VoronDesign/Voron-Stealthburner/README.md

# Voron Stealthburner

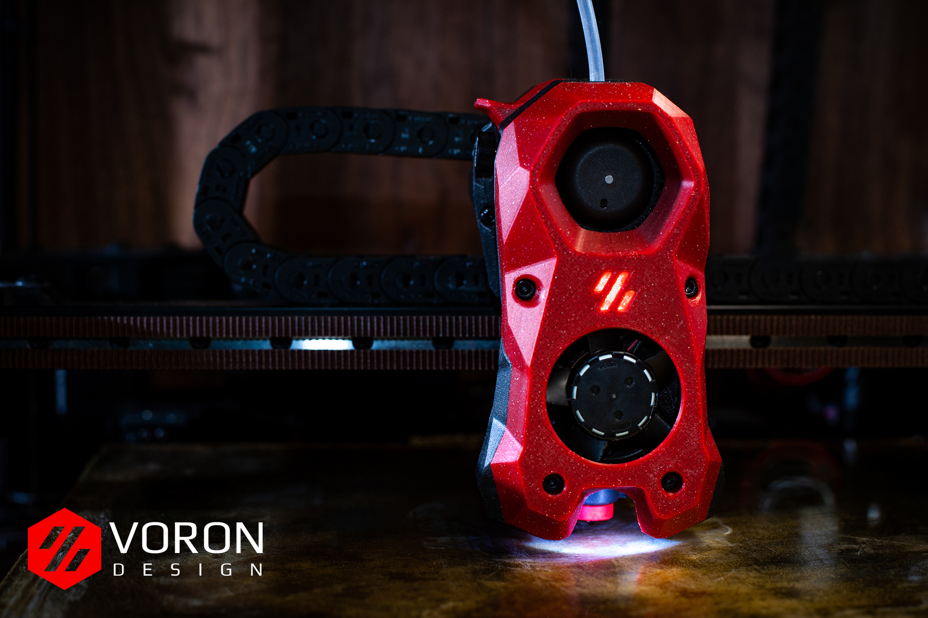
[picture p1: Images/Voron_Stealthburner.JPG]
Voron_Stealthburner
