VoronDesign/Voron-Stealthburner/STLs/README.md

# Filename Nomenclature

| Filename | Note |
|---|---|
| \*.stl | Base color |
| [a]\_\*.stl | Accent color |
| [o]\_\*.stl | Opaque (light doesn't penetrate) |
| [c]\_\*.stl | Clear/Translucent (light can penetrate) |
| \*\_cw1.stl | Clockwork1 Version |
| \*\_cw2.stl | Clockwork2 Version |
| \*\_SW.stl | Switchwire Version |

# NOTE: The X Carriage files are in each printers repo and not in the Stealthburner repo
