VoronDesign/Voron-Stealthburner/STLs/Clockwork2/Direct_Drive/main_body.stl

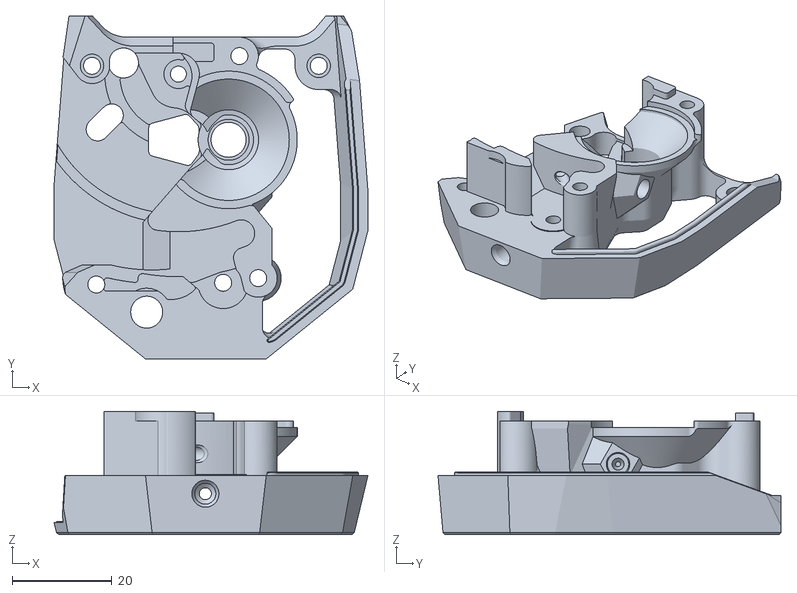
[picture p3: CAD file, 2023-07-12]
STLs/Clockwork2/Direct_Drive/main_body.stl
62.8 x 68.7 x 24.7
