VoronDesign/Voron-Stealthburner/STLs/Stealthburner/[a]_stealthburner_main_body.stl

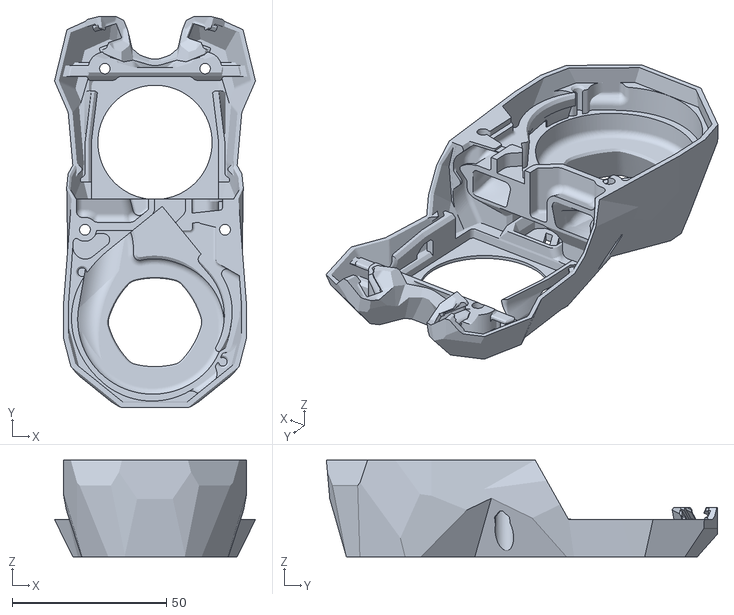
[picture p4: CAD file, 2026-11-07]
STLs/Stealthburner/[a]_stealthburner_main_body.stl
65.1 x 126.8 x 31.4
