VoronDesign/Voron-Stealthburner/STLs/Clockwork2.5/Direct_Drive/main_body_collet.stl

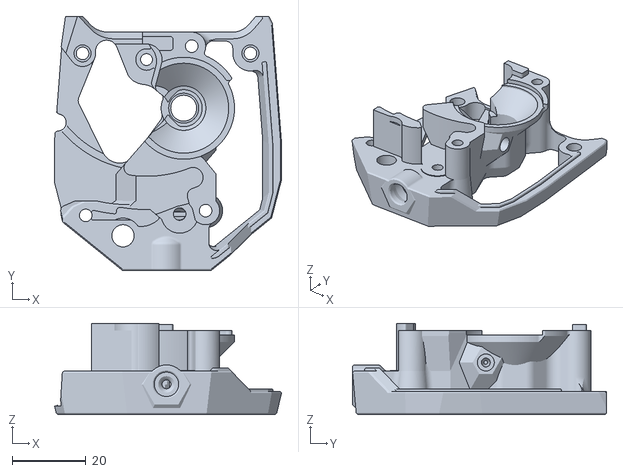
[picture p5: CAD file, 2026-11-07]
STLs/Clockwork2.5/Direct_Drive/main_body_collet.stl
61.4 x 68.7 x 24.7
