VoronDesign/Voron-Stealthburner/CAD/Printheads/Stealthburner_Printhead_Dragon.step

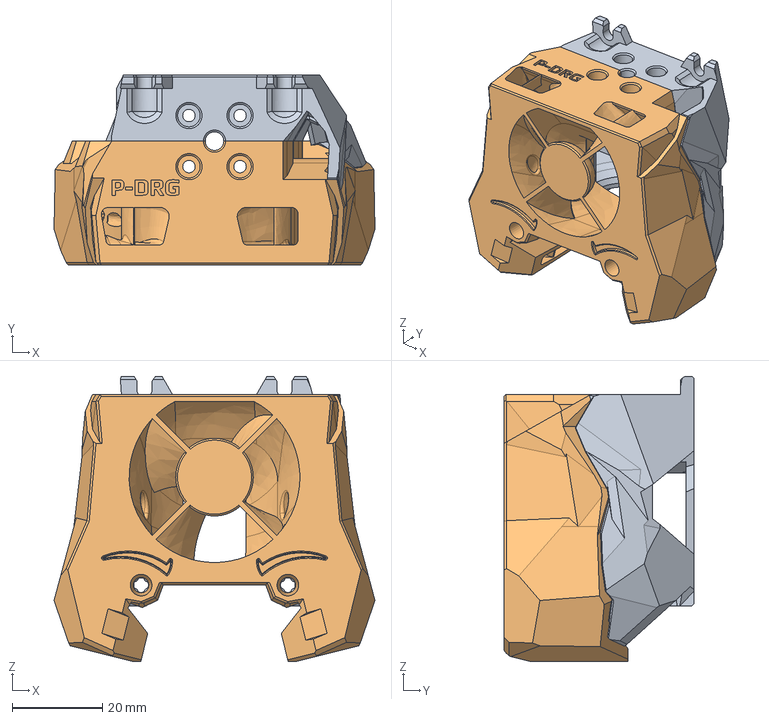
[picture p7: CAD file, 2026-11-07]
CAD/Printheads/Stealthburner_Printhead_Dragon.step
71.1 x 42.0 x 63.1 mm
