VoronDesign/Voron-Stealthburner/STLs/Clockwork2.5/chain_anchor_2hole_SW.stl

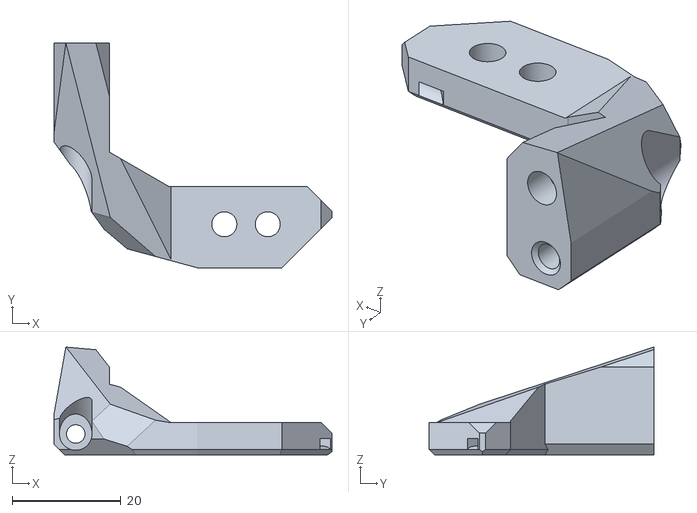
[picture p8: CAD file, 2026-11-07]
STLs/Clockwork2.5/chain_anchor_2hole_SW.stl
51.2 x 41.3 x 19.9
