VoronDesign/Voron-Stealthburner/STLs/Clockwork2.5/Direct_Drive/motor_plate.stl

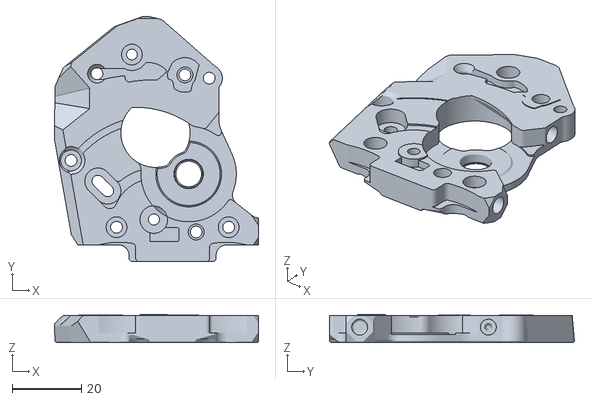
[picture p9: CAD file, 2026-11-08]
STLs/Clockwork2.5/Direct_Drive/motor_plate.stl
59.1 x 70.8 x 8.20
