VoronDesign/Voron-Stealthburner/STLs/Clockwork2/Bowden/front_stealthburner_bowden_ECAS_x1.stl

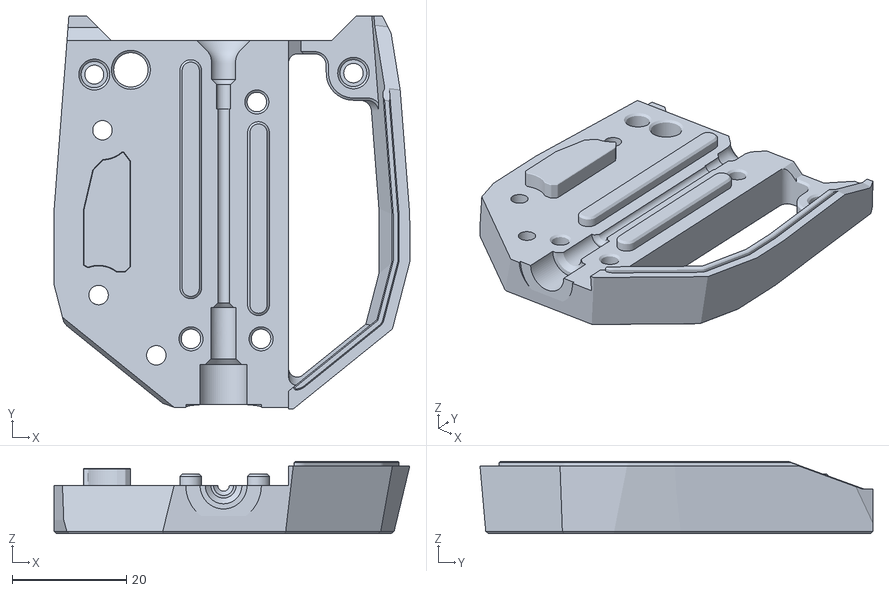
[picture p10: CAD file, 2023-07-11]
STLs/Clockwork2/Bowden/front_stealthburner_bowden_ECAS_x1.stl
62.2 x 68.7 x 12.6
