VoronDesign/Voron-Stealthburner/STLs/Clockwork2/chain_anchor_3hole_SW.stl

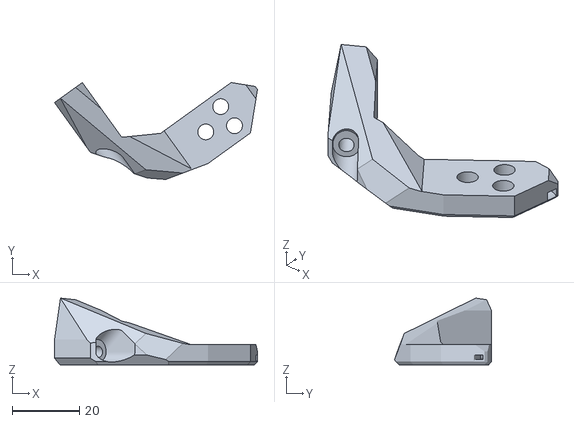
[picture p11: CAD file, 2023-09-07]
STLs/Clockwork2/chain_anchor_3hole_SW.stl
60.3 x 28.8 x 19.9
