VoronDesign/Voron-Stealthburner/STLs/Stealthburner/ADXL345_Mounts/sb_adxl_mount_ldo_15mm_c_c.stl

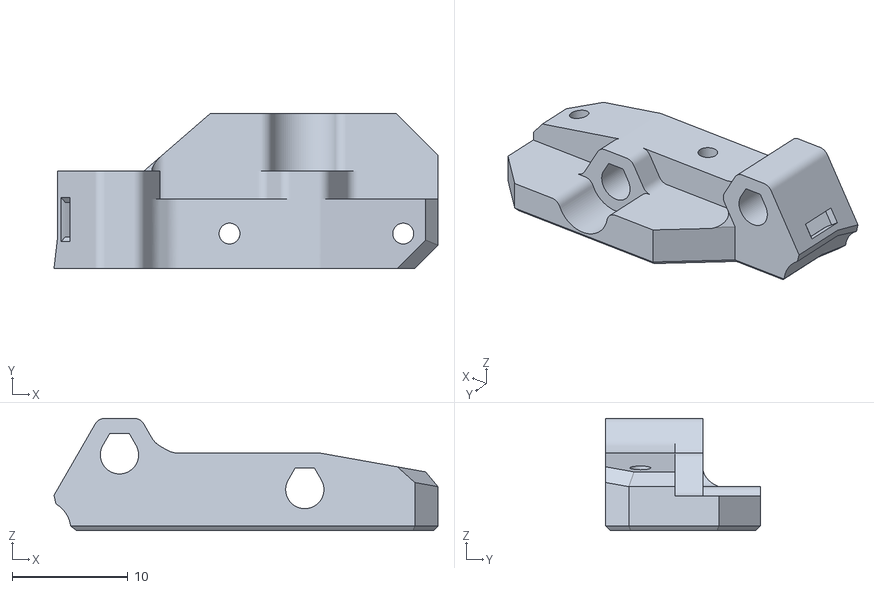
[picture p12: CAD file, 2022-07-23]
STLs/Stealthburner/ADXL345_Mounts/sb_adxl_mount_ldo_15mm_c_c.stl
33.2 x 13.4 x 9.70
