VoronDesign/Voron-Stealthburner/STLs/Stealthburner/Printheads/chube_compact/stealthburner_printhead_chube_compact_rear_cw2.stl

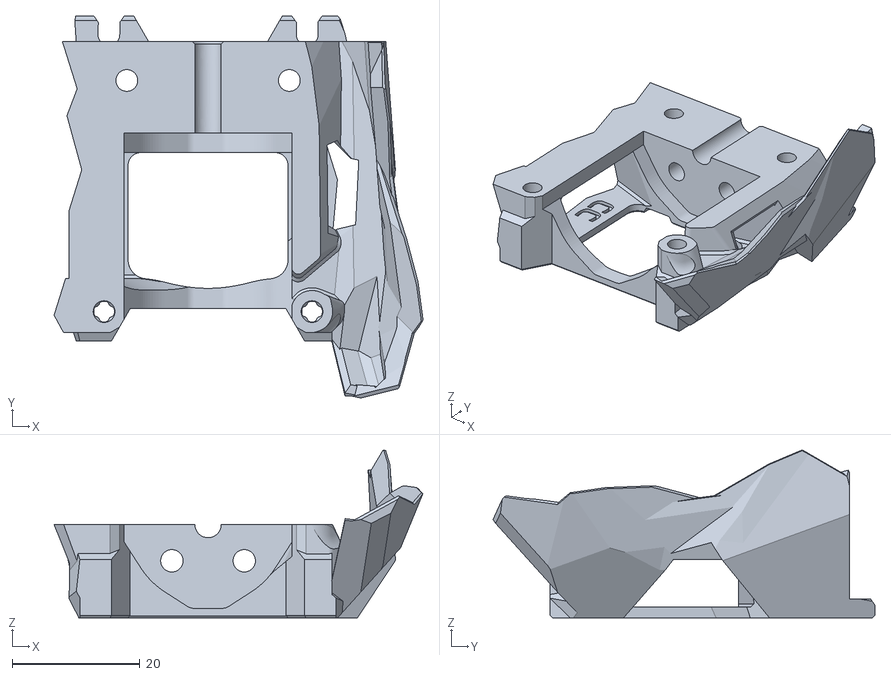
[picture p13: CAD file, 2026-11-07]
STLs/Stealthburner/Printheads/chube_compact/stealthburner_printhead_chube_compact_rear_cw2.stl
57.7 x 59.7 x 26.3
