VoronDesign/Voron-Stealthburner/STLs/Stealthburner/Printheads/phaetus_bmo/stealthburner_printhead_phaetus_bmo_rear_cw2.stl

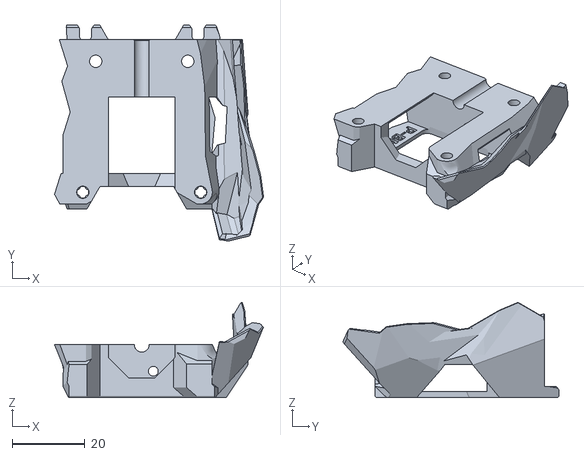
[picture p14: CAD file, 2026-11-07]
STLs/Stealthburner/Printheads/phaetus_bmo/stealthburner_printhead_phaetus_bmo_rear_cw2.stl
57.7 x 59.7 x 26.3
