VoronDesign/Voron-Stealthburner/STLs/Stealthburner/Printheads/phaetus_rapido_v2/stealthburner_printhead_rapido_v2_front.stl

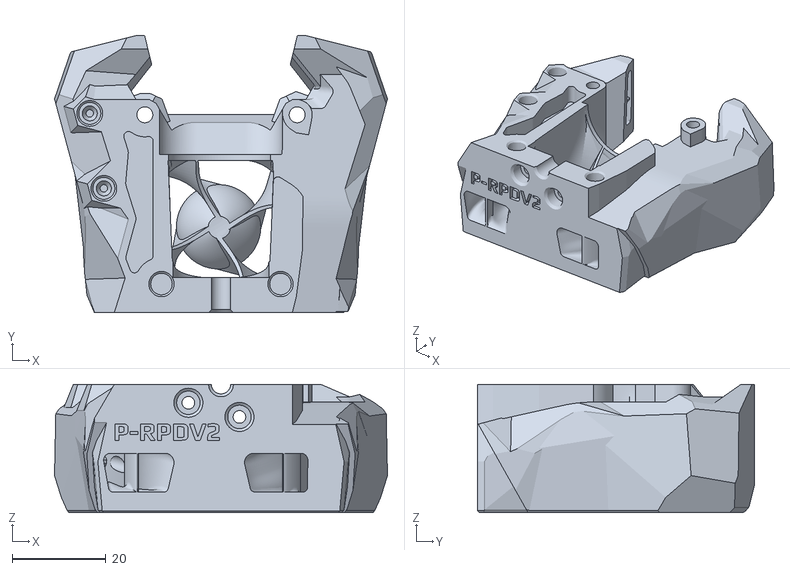
[picture p15: CAD file, 2026-11-07]
STLs/Stealthburner/Printheads/phaetus_rapido_v2/stealthburner_printhead_rapido_v2_front.stl
71.1 x 59.1 x 27.4
