VoronDesign/Voron-Stealthburner/STLs/Stealthburner/Printheads/revo_six_and_v6/stealthburner_printhead_v6_r6_rear_cw2.stl

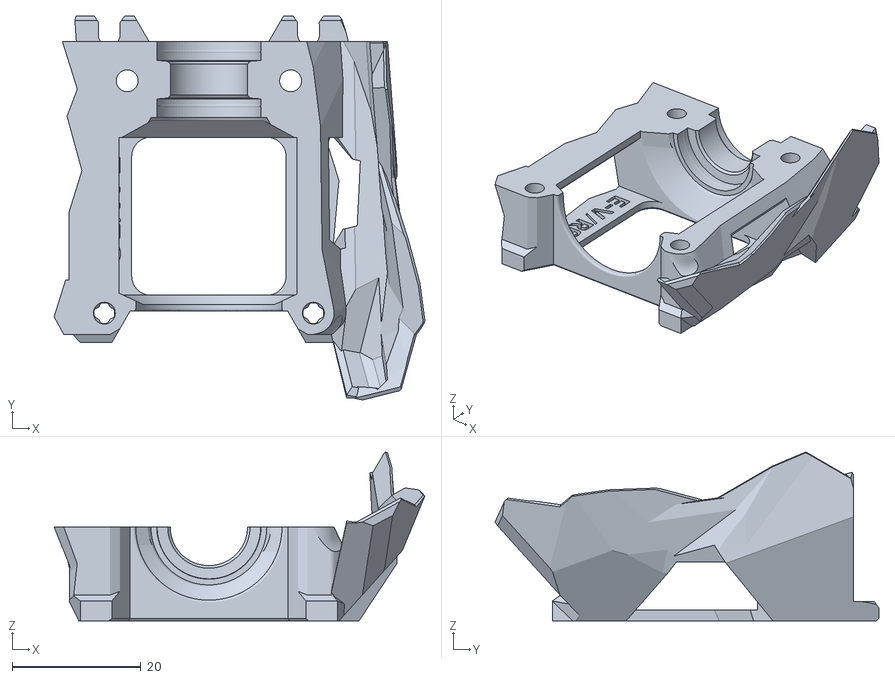
[picture p16: CAD file, 2022-09-28]
STLs/Stealthburner/Printheads/revo_six_and_v6/stealthburner_printhead_v6_r6_rear_cw2.stl
57.7 x 59.7 x 26.3
