VoronDesign/Voron-Stealthburner/STLs/Tools/SB_5015_Cutting_Tool_B.stl

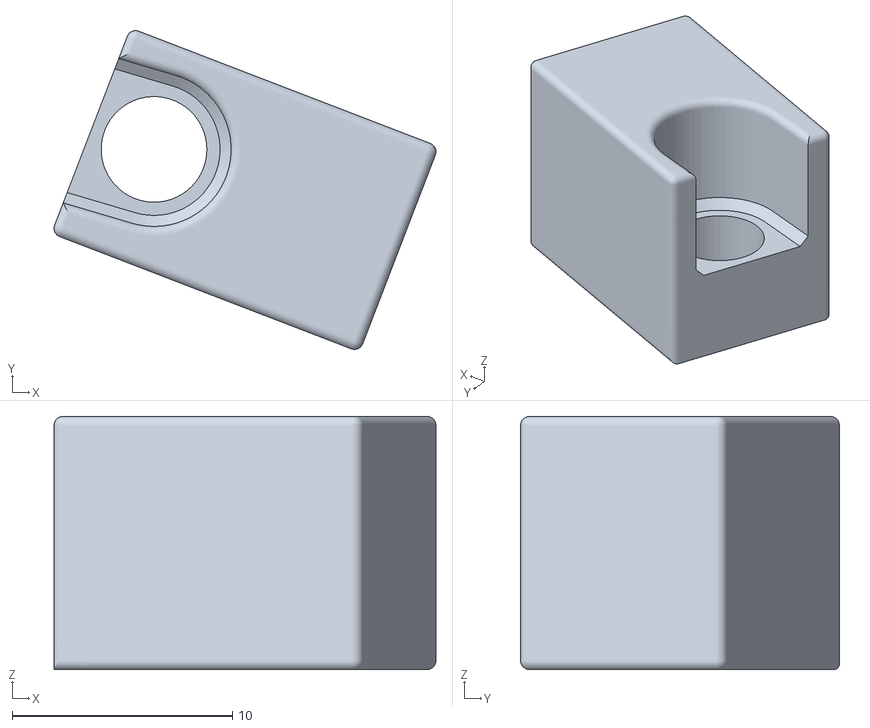
[picture p17: CAD file, 2022-07-25]
STLs/Tools/SB_5015_Cutting_Tool_B.stl
17.4 x 14.5 x 11.5
