VoronDesign/Voron-Stealthburner/CAD/Printheads/Stealthburner_Printhead_Rapido.step

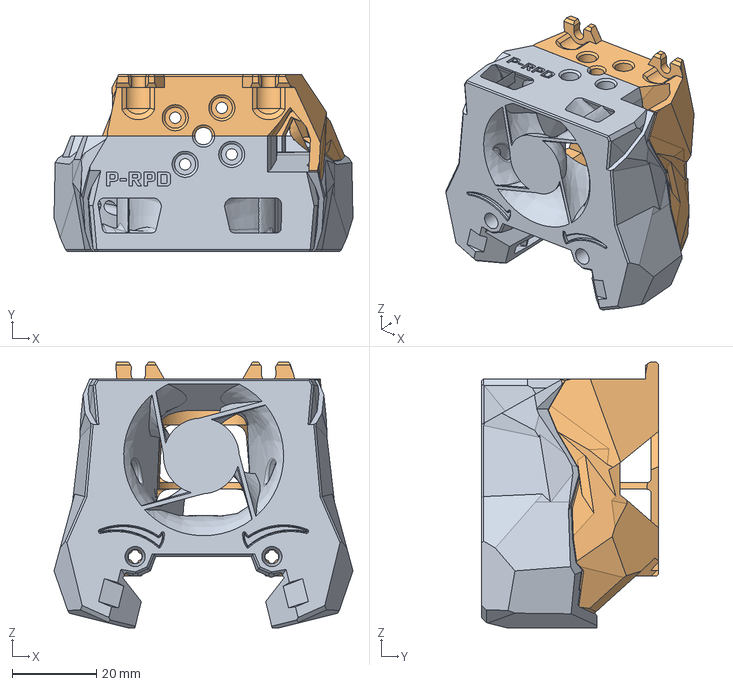
[picture p18: CAD file, 2026-11-07]
CAD/Printheads/Stealthburner_Printhead_Rapido.step
71.1 x 42.0 x 63.1 mm
SBRapido TH Front
SBRapido TH Rear CW2
