VoronDesign/Voron-Stealthburner/STLs/Clockwork2.5/Direct_Drive/[a]_guidler_b.stl

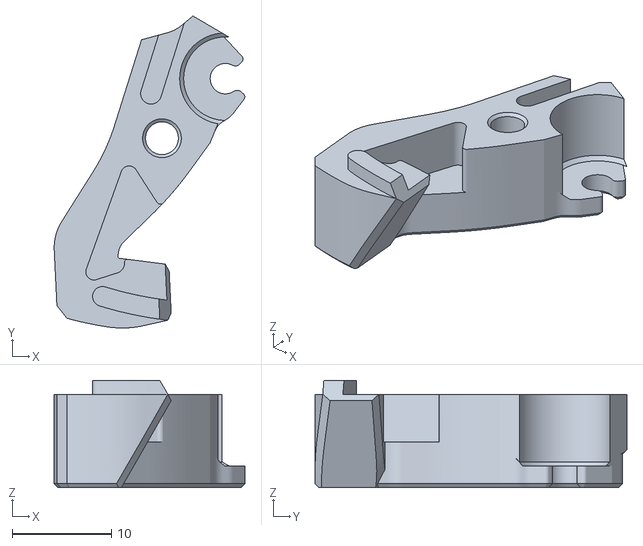
[picture p20: CAD file, 2026-11-07]
STLs/Clockwork2.5/Direct_Drive/[a]_guidler_b.stl
19.2 x 31.4 x 10.8
