VoronDesign/Voron-Stealthburner/STLs/Clockwork2/chain_anchor_2hole_SW.stl

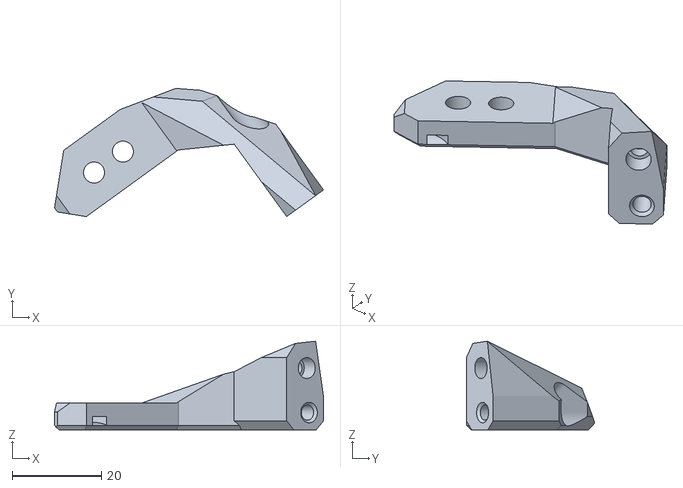
[picture p21: CAD file, 2023-09-07]
STLs/Clockwork2/chain_anchor_2hole_SW.stl
60.3 x 28.7 x 19.9
