VoronDesign/Voron-Stealthburner/STLs/Clockwork2/Direct_Drive/[a]_latch.stl

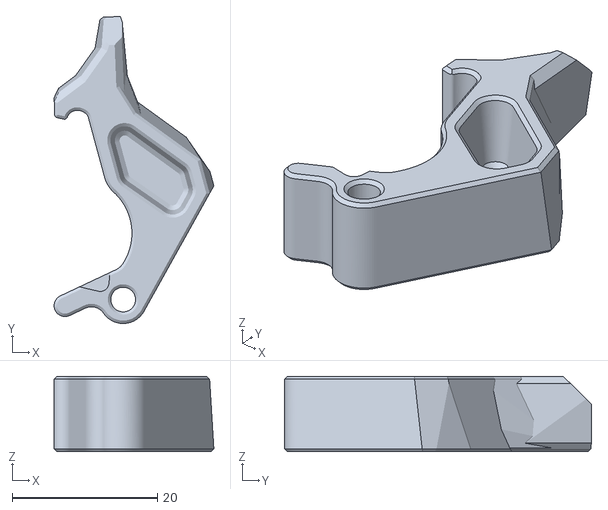
[picture p22: CAD file, 2023-07-11]
STLs/Clockwork2/Direct_Drive/[a]_latch.stl
22.0 x 42.3 x 10.4
