VoronDesign/Voron-Stealthburner/STLs/Stealthburner/[o]_stealthburner_LED_carrier.stl

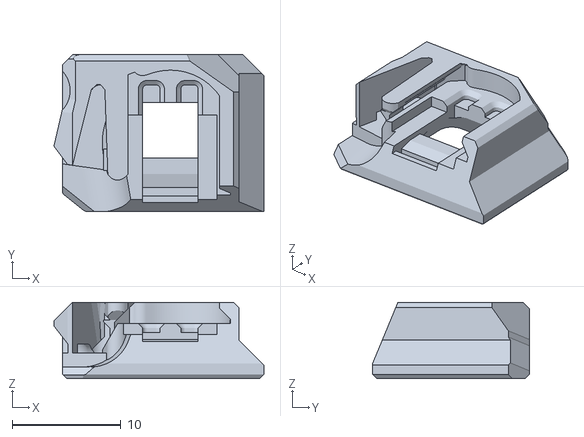
[picture p23: CAD file, 2022-07-23]
STLs/Stealthburner/[o]_stealthburner_LED_carrier.stl
19.3 x 14.4 x 7.01
