VoronDesign/Voron-Stealthburner/STLs/Stealthburner/ADXL345_Mounts/sb_adxl_mount_sparkfun_LIS3DH.stl

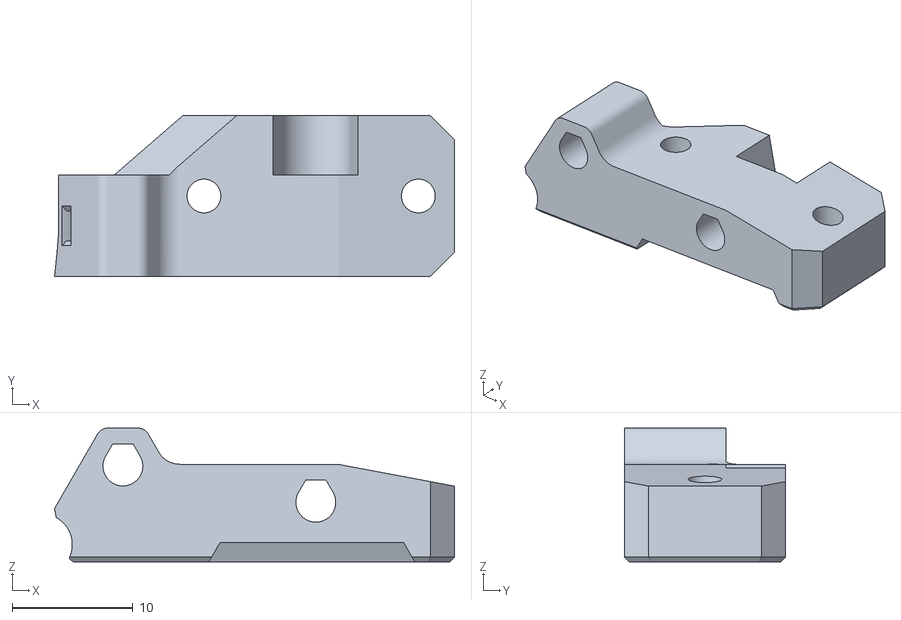
[picture p24: CAD file, 2022-07-23]
STLs/Stealthburner/ADXL345_Mounts/sb_adxl_mount_sparkfun_LIS3DH.stl
33.2 x 13.4 x 11.1
