VoronDesign/Voron-Stealthburner/STLs/Stealthburner/Printheads/phaetus_bms/stealthburner_printhead_phaetus_bms7_front.stl

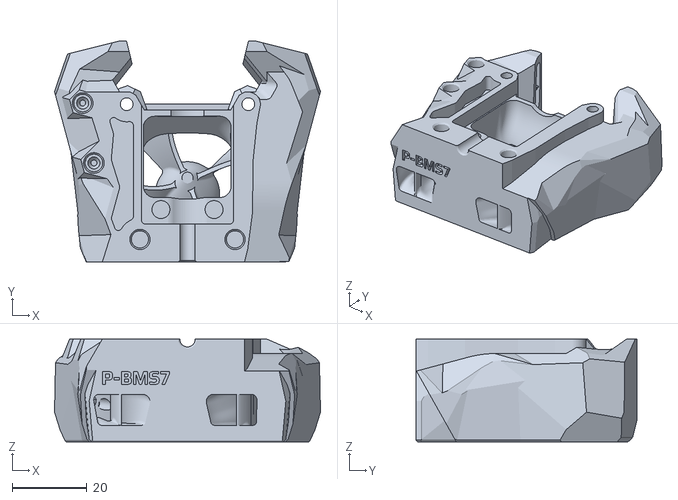
[picture p25: CAD file, 2026-11-07]
STLs/Stealthburner/Printheads/phaetus_bms/stealthburner_printhead_phaetus_bms7_front.stl
71.1 x 59.1 x 27.4
