VoronDesign/Voron-Stealthburner/STLs/Stealthburner/Printheads/phaetus_rapido_v2/stealthburner_printhead_rapido_v2_rear_cw1.stl

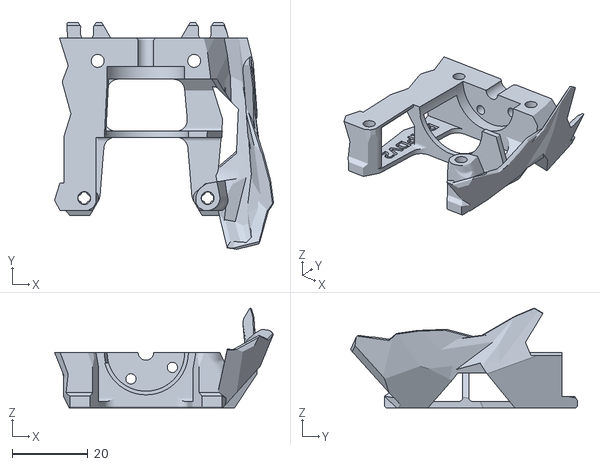
[picture p26: CAD file, 2023-10-24]
STLs/Stealthburner/Printheads/phaetus_rapido_v2/stealthburner_printhead_rapido_v2_rear_cw1.stl
57.7 x 59.7 x 26.3
