VoronDesign/Voron-Stealthburner/STLs/Stealthburner/Printheads/revo_micro/stealthburner_printhead_revo_micro_rear_cw2.stl

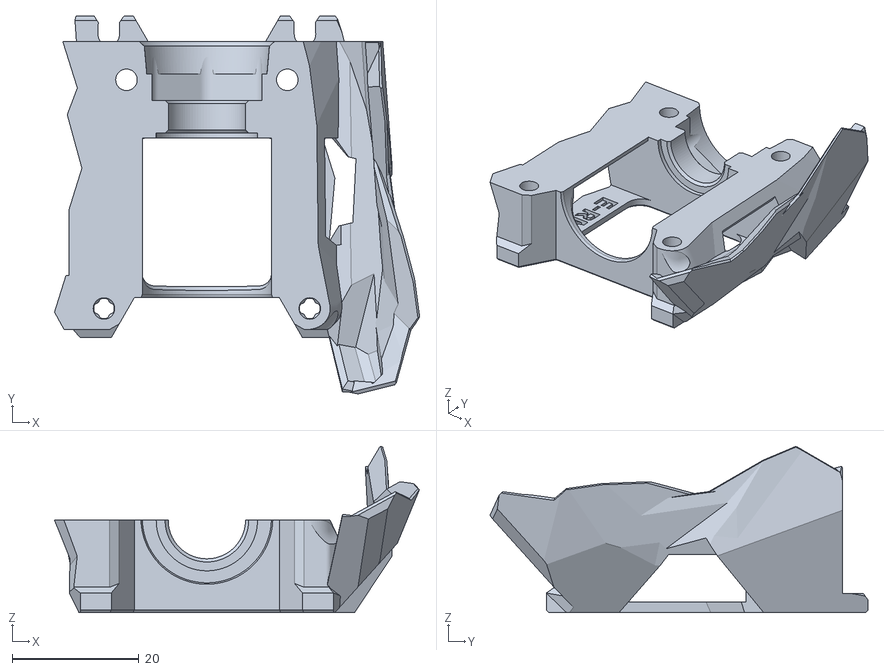
[picture p27: CAD file, 2022-09-28]
STLs/Stealthburner/Printheads/revo_micro/stealthburner_printhead_revo_micro_rear_cw2.stl
57.7 x 59.7 x 26.3
