VoronDesign/Voron-Stealthburner/STLs/Tools/SB_5015_Cutting_Tool_A.stl

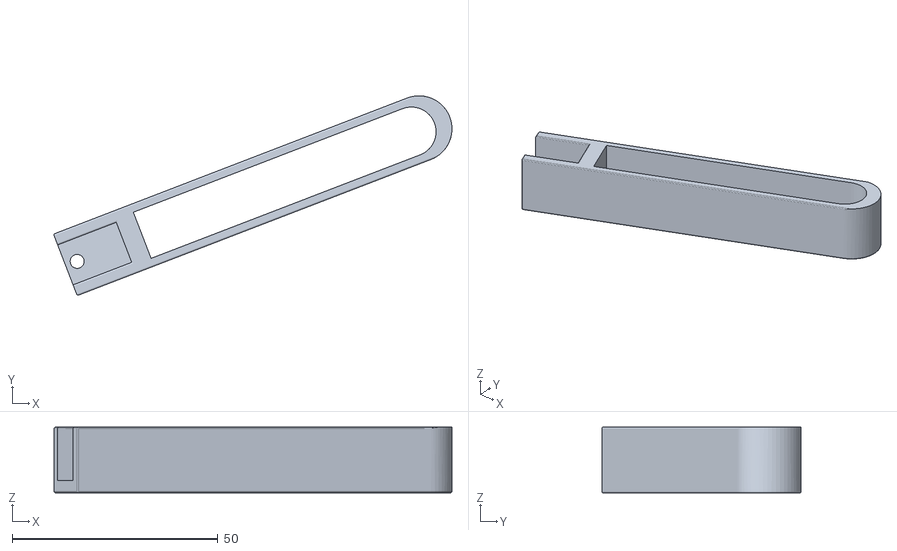
[picture p28: CAD file, 2022-07-25]
STLs/Tools/SB_5015_Cutting_Tool_A.stl
96.6 x 48.4 x 16.0
