VoronDesign/Voron-Stealthburner/STLs/Clockwork2.5/chain_anchor_3hole.stl

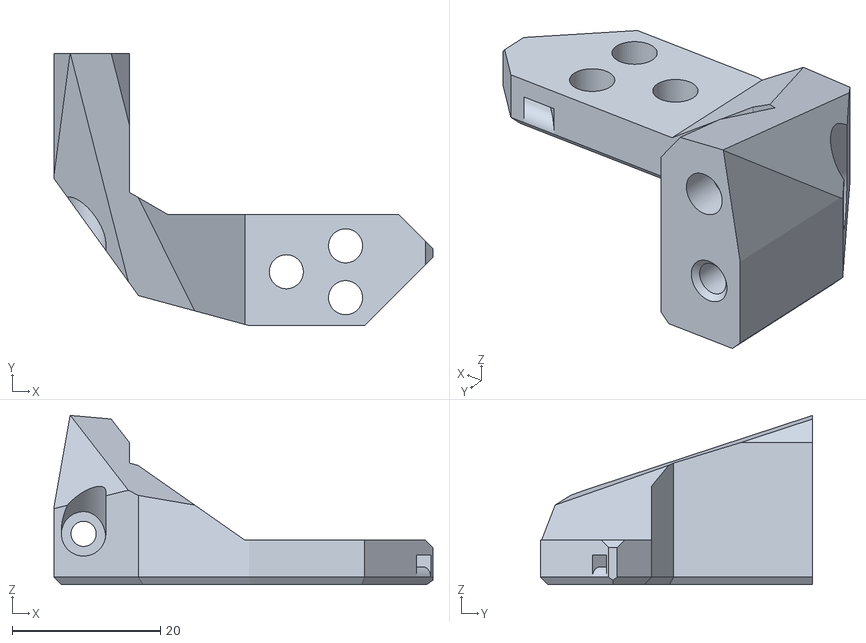
[picture p29: CAD file, 2026-11-07]
STLs/Clockwork2.5/chain_anchor_3hole.stl
51.2 x 36.8 x 22.9
