VoronDesign/Voron-Stealthburner/STLs/Clockwork2.5/Direct_Drive/[a]_hall_effect_bracket_diy.stl

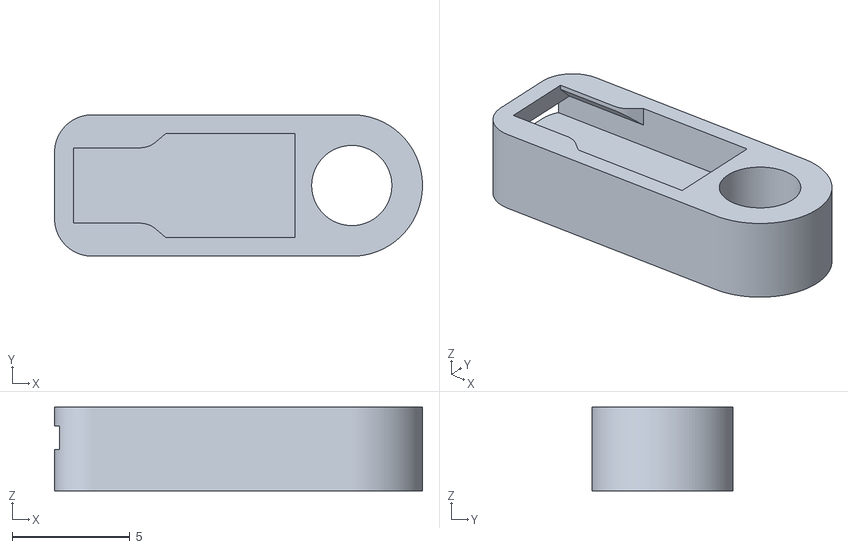
[picture p30: CAD file, 2026-11-07]
STLs/Clockwork2.5/Direct_Drive/[a]_hall_effect_bracket_diy.stl
15.6 x 6.00 x 3.55
