VoronDesign/Voron-Stealthburner/STLs/Clockwork2/Bowden/rear_stealthburner_bowden_ECAS_cw2_x1.stl

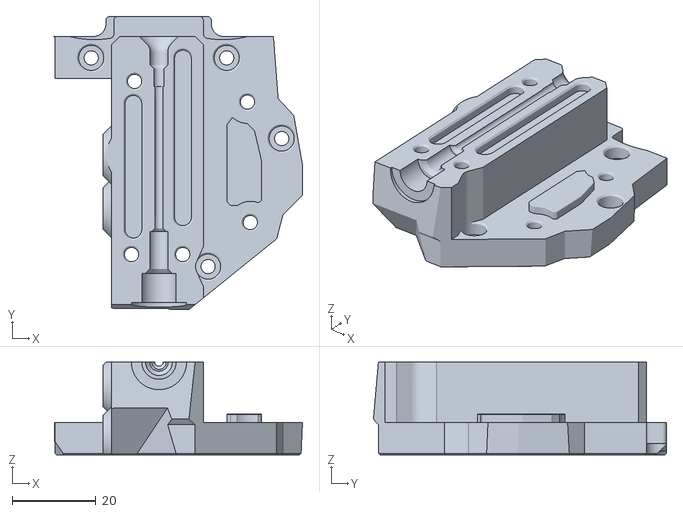
[picture p31: CAD file, 2023-07-11]
STLs/Clockwork2/Bowden/rear_stealthburner_bowden_ECAS_cw2_x1.stl
59.3 x 70.1 x 22.2
