VoronDesign/Voron-Stealthburner/STLs/Clockwork2/Direct_Drive/motor_plate.stl

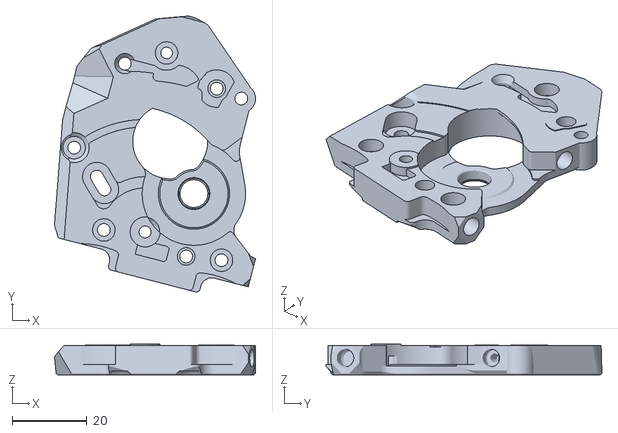
[picture p32: CAD file, 2023-07-11]
STLs/Clockwork2/Direct_Drive/motor_plate.stl
53.7 x 73.6 x 8.20
