VoronDesign/Voron-Stealthburner/STLs/Stealthburner/[c]_stealthburner_LED_diffuser.stl

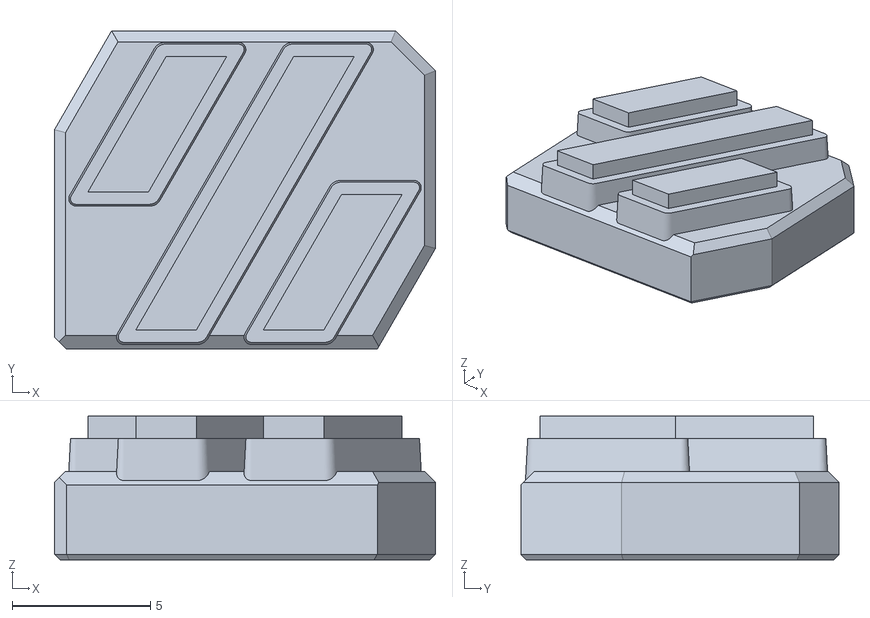
[picture p33: CAD file, 2022-07-23]
STLs/Stealthburner/[c]_stealthburner_LED_diffuser.stl
13.8 x 11.5 x 5.20
