VoronDesign/Voron-Stealthburner/STLs/Stealthburner/Printheads/phaetus_rapido_v2/stealthburner_printhead_rapido_v2_rear_cw2.stl

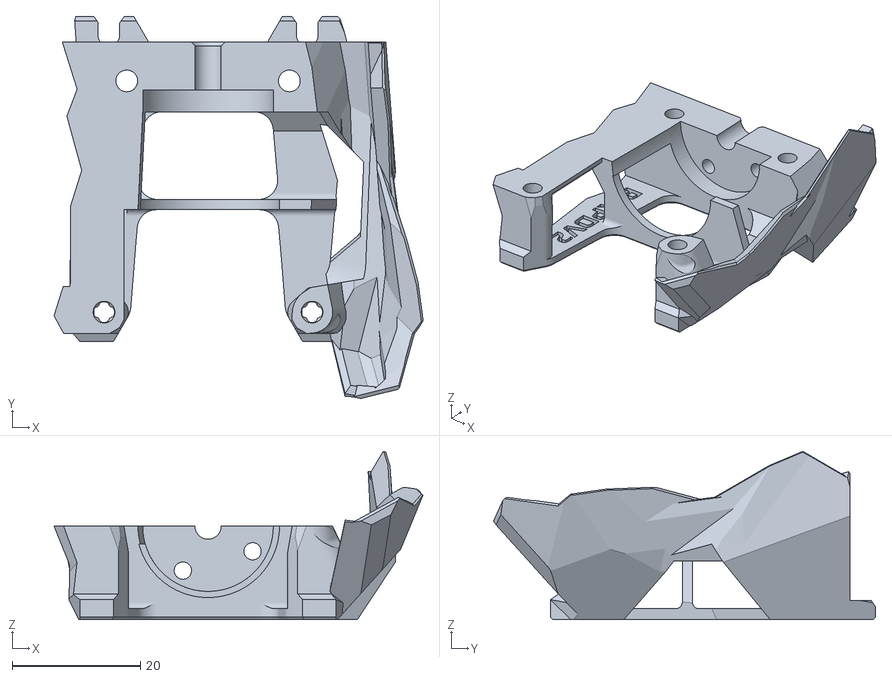
[picture p34: CAD file, 2023-10-24]
STLs/Stealthburner/Printheads/phaetus_rapido_v2/stealthburner_printhead_rapido_v2_rear_cw2.stl
57.7 x 59.7 x 26.3
