VoronDesign/Voron-Stealthburner/STLs/Clockwork2/Bowden/[a]_front_stealthburner_bowden_spacer_x1.stl

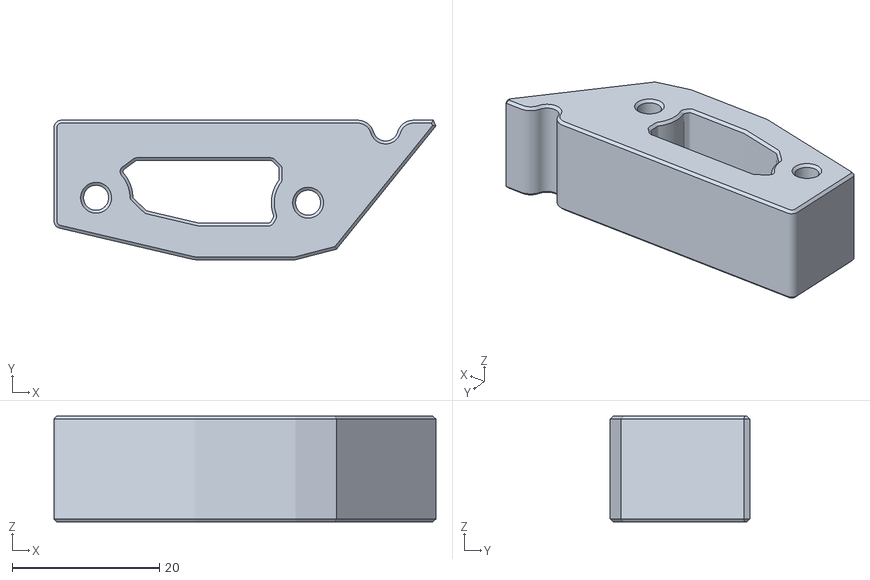
[picture p35: CAD file, 2023-07-11]
STLs/Clockwork2/Bowden/[a]_front_stealthburner_bowden_spacer_x1.stl
51.9 x 19.0 x 14.4
