VoronDesign/Voron-Stealthburner/STLs/Clockwork2/chain_anchor_2hole.stl

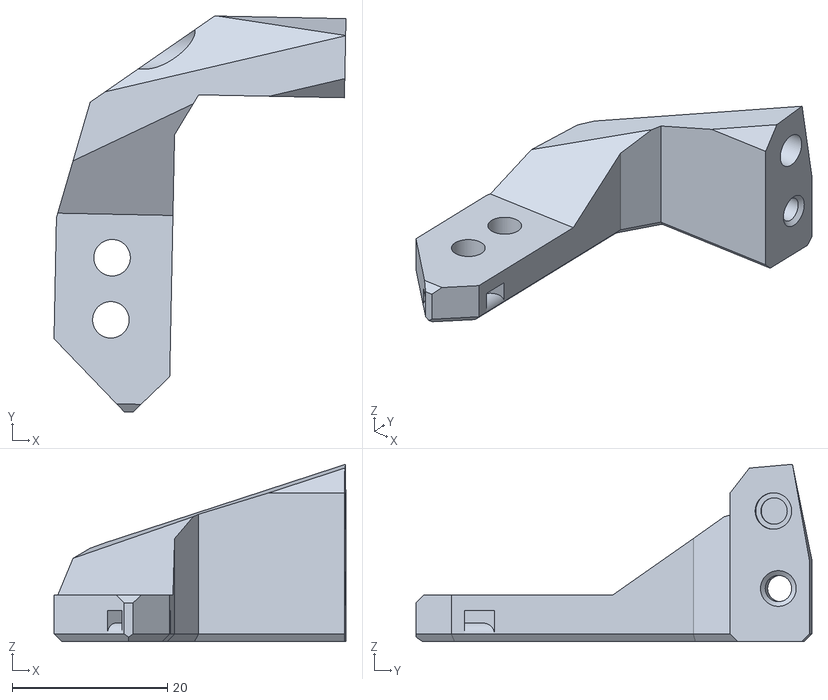
[picture p36: CAD file, 2023-09-07]
STLs/Clockwork2/chain_anchor_2hole.stl
37.6 x 51.0 x 22.9
