VoronDesign/Voron-Stealthburner/STLs/Clockwork2/Direct_Drive/[a]_guidler_a.stl

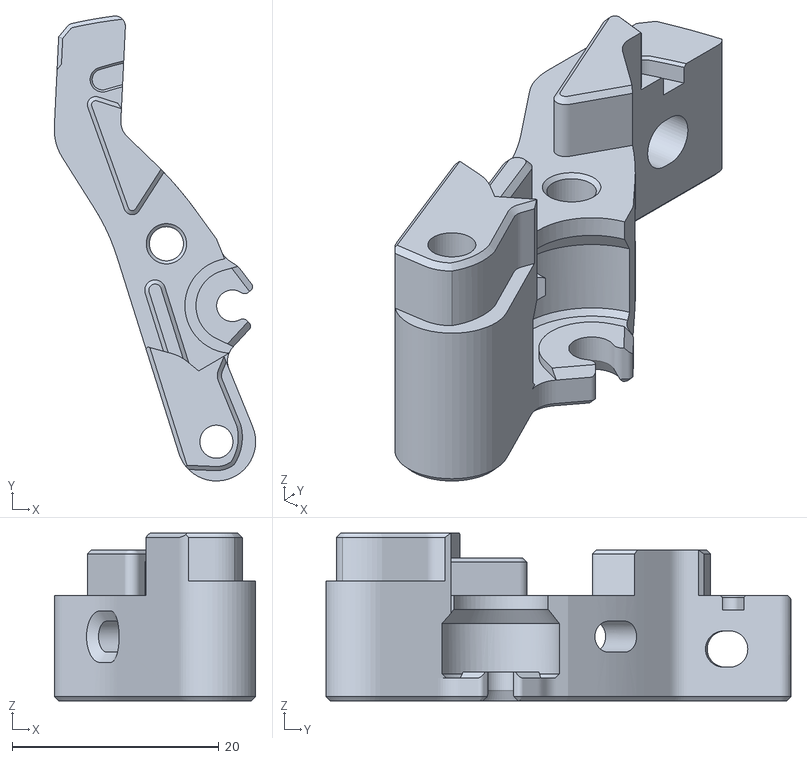
[picture p37: CAD file, 2023-01-24]
STLs/Clockwork2/Direct_Drive/[a]_guidler_a.stl
19.5 x 45.0 x 16.2
