VoronDesign/Voron-Stealthburner/STLs/Stealthburner/[o]_stealthburner_LED_diffuser_mask.stl

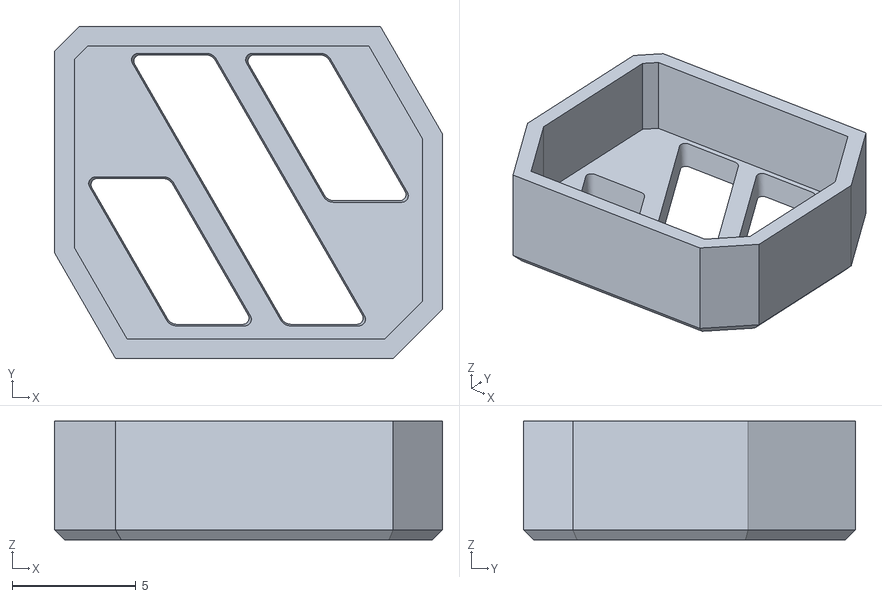
[picture p38: CAD file, 2022-07-23]
STLs/Stealthburner/[o]_stealthburner_LED_diffuser_mask.stl
15.7 x 13.4 x 4.80
