VoronDesign/Voron-Stealthburner/STLs/Stealthburner/ADXL345_Mounts/sb_adxl_mount_adafruit_LIS3DH.stl

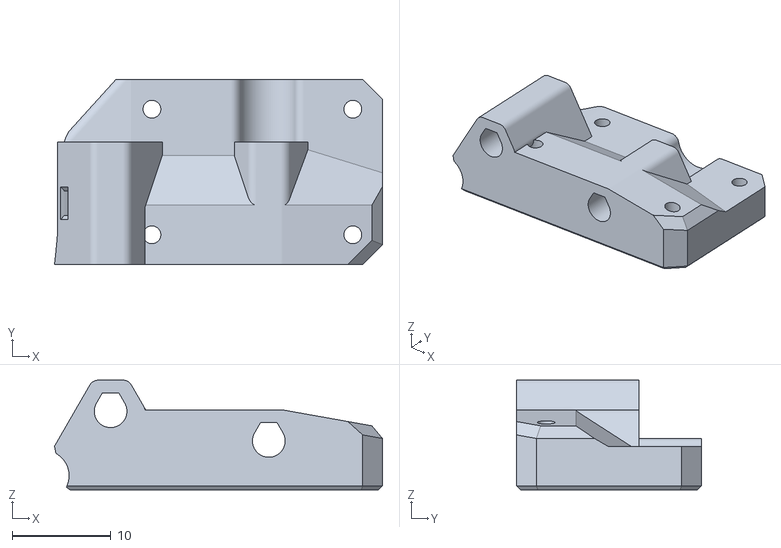
[picture p39: CAD file, 2022-07-23]
STLs/Stealthburner/ADXL345_Mounts/sb_adxl_mount_adafruit_LIS3DH.stl
33.2 x 18.7 x 11.1
