VoronDesign/Voron-Stealthburner/STLs/Clockwork2.5/Direct_Drive/[a]_hall_effect_bracket.stl

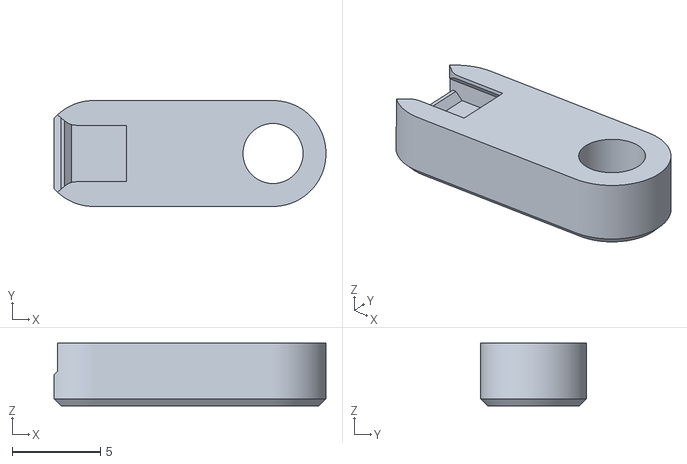
[picture p41: CAD file, 2026-11-07]
STLs/Clockwork2.5/Direct_Drive/[a]_hall_effect_bracket.stl
15.4 x 6.00 x 3.55
