VoronDesign/Voron-Stealthburner/STLs/Clockwork2/cable_door_for_pcb.stl

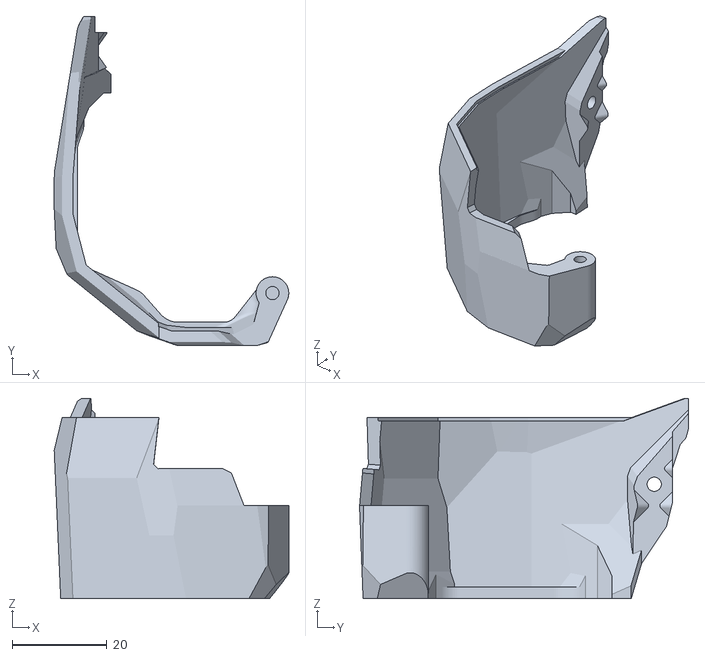
[picture p42: CAD file, 2022-07-30]
STLs/Clockwork2/cable_door_for_pcb.stl
49.5 x 69.4 x 42.2
