VoronDesign/Voron-Stealthburner/STLs/Clockwork2.5/Direct_Drive/[a]_guidler_a.stl

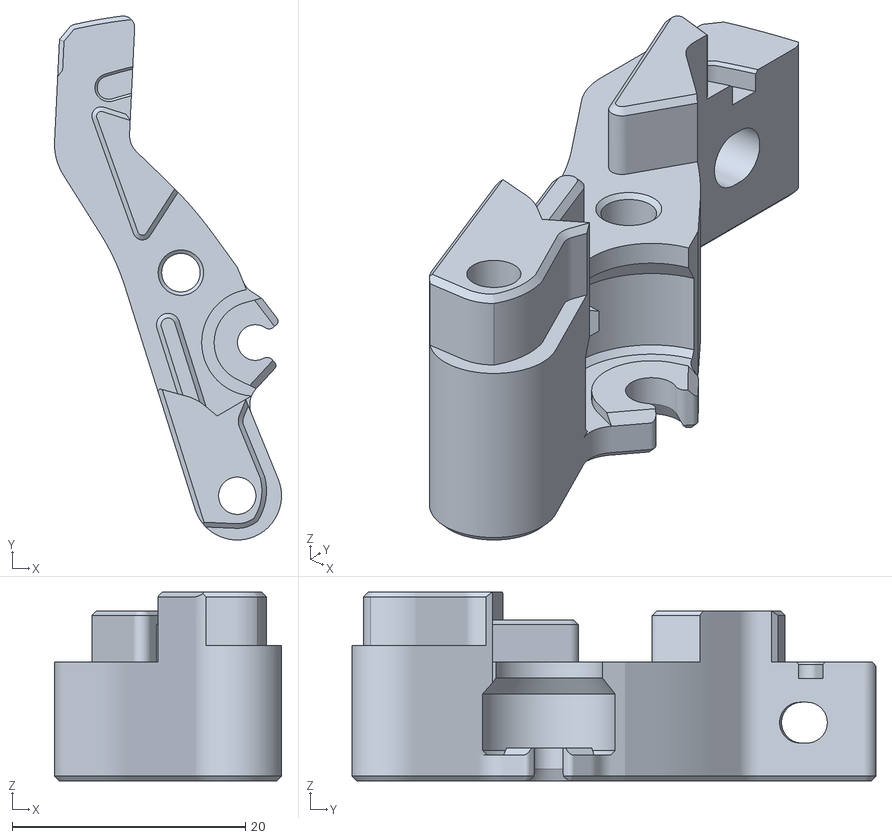
[picture p43: CAD file, 2026-11-07]
STLs/Clockwork2.5/Direct_Drive/[a]_guidler_a.stl
19.5 x 45.0 x 16.2
