VoronDesign/Voron-Stealthburner/STLs/Clockwork2/cable_door.stl

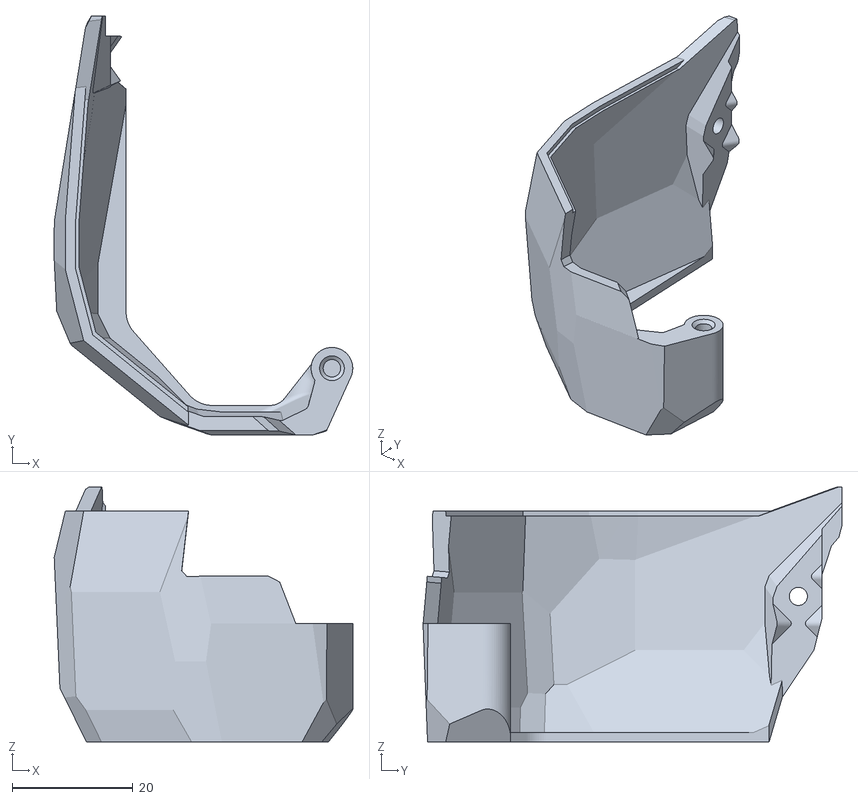
[picture p44: CAD file, 2022-07-23]
STLs/Clockwork2/cable_door.stl
49.4 x 69.4 x 42.2
