VoronDesign/Voron-Stealthburner/STLs/Clockwork2/Direct_Drive/[a]_latch_shuttle.stl

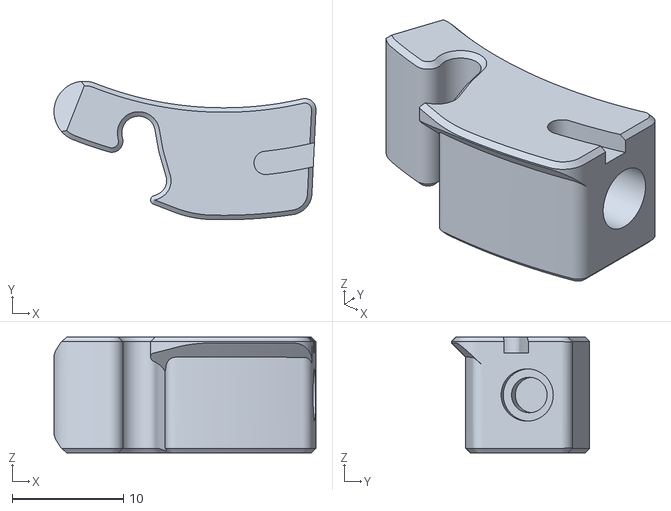
[picture p45: CAD file, 2022-07-23]
STLs/Clockwork2/Direct_Drive/[a]_latch_shuttle.stl
23.6 x 12.5 x 10.4
