VoronDesign/Voron-Stealthburner/STLs/Clockwork2/[a]_pcb_spacer.stl

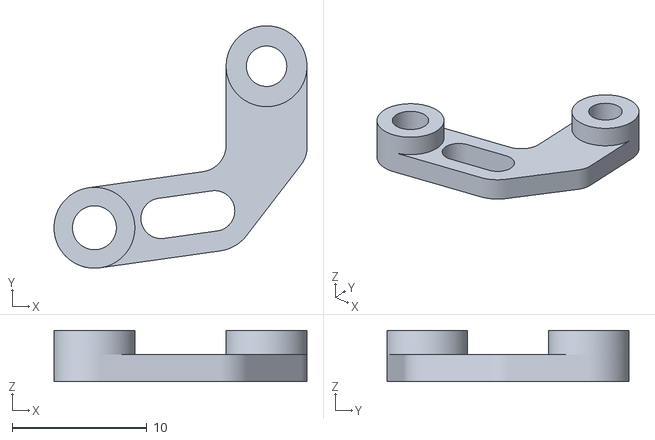
[picture p46: CAD file, 2022-07-23]
STLs/Clockwork2/[a]_pcb_spacer.stl
18.8 x 18.0 x 3.80
