VoronDesign/Voron-Stealthburner/(list of files, cad)

Other CAD files:
STLs/Stealthburner/Printheads/phaetus_bms/stealthburner_printhead_phaetus_bms7_rear_cw2.stl
STLs/Stealthburner/Printheads/phaetus_dragon/stealthburner_printhead_dragon_rear_cw2.stl
STLs/Stealthburner/Printheads/revo_micro/stealthburner_printhead_revo_micro_front.stl
STLs/Stealthburner/Printheads/revo_voron/stealthburner_printhead_revo_voron_rear_cw2.stl
STLs/Clockwork2/Bowden/front_stealthburner_bowden_M10_x1.stl
STLs/Stealthburner/Printheads/phaetus_bmo/stealthburner_printhead_phaetus_bmo_front.stl
STLs/Stealthburner/Printheads/phaetus_dragon/stealthburner_printhead_dragon_front.stl
CAD/Printheads/Stealthburner_Printhead_Phaetus_BMS_7_Fin.step
STLs/Clockwork2/chain_anchor_3hole.stl
STLs/Stealthburner/ADXL345_Mounts/sb_adxl_mount_adafruit_19mm_c_c.stl
STLs/Stealthburner/Printheads/phaetus_bmo/stealthburner_printhead_phaetus_bmo_rear_cw1.stl
STLs/Stealthburner/Printheads/phaetus_bms/stealthburner_printhead_phaetus_bms6_front.stl
CAD/Printheads/Stealthburner_Printhead_RevoMicro.step
STLs/Stealthburner/Printheads/phaetus_bms/stealthburner_printhead_phaetus_bms6_rear_cw2.stl
STLs/Clockwork2/Direct_Drive/[a]_guidler_b.stl
CAD/Printheads/Stealthburner_Printhead_RevoVoron.step
STLs/Stealthburner/ADXL345_Mounts/sb_adxl_mount_generic_15.5mm_c_c.stl
CAD/Printheads/Stealthburner_Printhead_Rapido_V2.step
CAD/Bowden_Module/Bowden_Module.f3d
STLs/Stealthburner/ADXL345_Mounts/sb_adxl_washer_x2.stl
STLs/Stealthburner/Printheads/phaetus_rapido/stealthburner_printhead_rapido_rear_cw2.stl
Superseded_Parts/STLs/Clockwork2/Bowden/rear_stealthburner_bowden_M10_cw2_x1.stl
