VoronDesign/Voron-Stealthburner/(threads)

Thread 1 (2022-07-23):

Phaetus_bms6_front and Phaetus_bms7_front is the same STL.

JuicedEagle, 2022-07-23:
I have looked through the Phaetus BMS files, and when i open the front part stl file for bms 7 it is the BMS6 inscription on it.

and there is no visible difference between bms6_front and bms7_front.

nemgrea, 2022-07-25:
https://github.com/VoronDesign/Voron-Stealthburner/pull/9
fixed

Closed 2022-07-25.

Thread 4 (2022-07-24):

Cutting Jig missing

mkevenaar, 2022-07-24:
On page 55 of the documentation there is a mention of a cutting jig for the 5015 fan.

I am unable to find it in the STLs folder. I can't find it either in the BETA repository.

jtdowney, 2022-07-24:
I noticed that as well and came here to post. I believe it should be roughly the same as the 5015 deearing tool in https://github.com/VoronDesign/VoronUsers/tree/53778894972e58cf454b9c5ecdb856f19b2470c6/printer_mods/Badnoob/AB-BN/STL_files. That is what I've used for now.

nemgrea, 2022-07-25:
https://github.com/VoronDesign/Voron-Stealthburner/pull/10
Added

Closed 2022-07-25.

Thread 5 (2022-07-24):

Phaetus BMS (7 fin) real heatset insert hole misalignment

plumpcheek, 2022-07-24:
The heatset insert hole misalignment, picture include: Phaetus 7 fin in the left and 6 fin in the right.

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

nemgrea, 2022-07-25:
https://github.com/VoronDesign/Voron-Stealthburner/pull/9
fixed

Thread 6 (2022-07-24):

missing STL for X Carriage belt clips

boodaah71, 2022-07-24:
For the Switchwire X Carriage, there are 2 belt clips that were in the beta which are missing from the released version.

nemgrea, 2022-07-25:
https://github.com/VoronDesign/Voron-Stealthburner/pull/10
added

Closed 2022-07-25.

Thread 7 (2022-07-24):

Incorrect screw length in X-Carriage

MapleLeafMakers, 2022-07-24:
The M3x40 screw used to connect the 2 halves of the x-carriage should actually be an M3x30, M3x40 would stick out the other side:

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

The CAD also has this screw mis-labelled as M3x40 but it is in fact 30mm long.

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

wile-e1, 2022-07-30:
The issue has been corrected.  PR to be submitted shortly.

Closed 2022-07-30.

Thread 8 (2022-07-25):

Typo

berkus, 2022-07-25:
Assembly manual page 42 says "M3 MOUTING BOLTS?"

Should be MOUNTING perhaps.

mtaumike, 2022-07-25:
Mentioned in #2

raymondh2, 2022-07-25:
Duplicate of #2

berkus, 2022-07-26:
Ugh, didn't see that one, sorry!

Closed 2022-07-25.

Thread 13 (2022-07-26):

Klipper macros

jtdowney, 2022-07-26:
The repo is missing the klipper_macros folder from the beta, which has the config you'd need for the LEDs.

Grafton1046, 2022-07-27:
here's a link to the beta one
https://github.com/VoronDesign/Voron-Afterburner/blob/sb-beta/Klipper_Macros/stealthburner_leds.cfg

jtdowney, 2022-07-27:
@Grafton1046 This issue is to point out that that needs to be copied here.

nemgrea, 2022-07-27:
addressed
https://github.com/VoronDesign/Voron-Stealthburner/pull/15

Closed 2022-07-27.

Thread 14 (2022-07-26):

dragonfly BMS 7 fin

elvin159, 2022-07-26:
the dragonfly BMS 7fin file stealthburner_printhead_phaetus_bms7_front.stl has P-BMS6 imprinted on the toolhead STL pretty sure that should be P-BMS7 to avoid confusion.

nemgrea, 2022-07-27:
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

Closed 2022-07-27.

Thread 16 (2022-07-29):

STEP File Inconsistencies

ValuableToast, 2022-07-29:
There are a few inconsistencies with the STEP files compared to some of the well established files like the 2.4

- SW X Carriage CW2 - There are no part names here just body 1, 2, 3 etc.
- CW2 - Not colored

As a suggestion, why not have them all in a single file like afterburner is setup. It makes seeing the fitment of the three parts easier.

Thank you for your tireless work on this!!

wile-e1, 2022-07-30:
SW carriage has been fixed

Colors on CW2 have also been fixed.  There was some weird export issue from Inventor.  It took some digging but I got it solved.

PR incoming soon.

Closed 2022-07-30.

Thread 17 (2022-07-29):

Incorrect Screw Length for ADXL345 mounts

Drachenkaetzchen, 2022-07-29:
In the CAD, the two screws attaching the ADXL345 mount to the toolhead body are labelled as M3x16, but are in fact M3x12.

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

The manual doesn't mention the two screws, but it might give issues with a BOM when it's based on the CAD screws

wile-e1, 2022-07-30:
The issue has been corrected and a PR will be submitted shortly.

Closed 2022-07-30.

Thread 20 (2022-07-31):

Wrong screws on manual for mounting fan housing to assembly.

lococnc, 2022-07-31:
Too long a screw specified in manual.
Needs to be a M3x20 to attach the stealthburner upper screws, not M3x25

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

nemgrea, 2022-07-31:
This is not a mistake, 25mm screws are intentional as this allows the hotend to be dropped out without having to fully remove the front fan assembly

Closed 2022-07-31.

Thread 21 (2022-07-31):

Tool Cartridge and Dragon Hotend

narf222, 2022-07-31:
hi all,

just a small issue: on page 42 (manual from 2022-07-30) you mention M3x8 bolts to hold the hotend in place. the dragon hotend needs M2,5 x8mm. others won't fit the hotend but also don't find your printed part by design. the screw head would be to big to go into the hole of the printed part.

so, i'd suggest to write that at least in the annotations for the printheads (here: https://github.com/VoronDesign/Voron-Stealthburner/tree/main/STLs/Stealthburner/Printheads ) or in the manual, too. the thing is that some people may need to buy those screws extra (because M2,5 aren't part of any BOM). that's why it's an issue worth mentioning.

thanks for everything you awesome people :))

cheers
narf

bassco, 2022-08-01:
The M2.5x8mm bolts are supplied with the Dragon Hotend and are therefore not required in the BOM.

Agreed, that an annotation would be useful to clear this up.

wile-e1, 2022-08-02:
The M3x8 are for the Revo Voron toolhead shown in the manual,  hence the note "M3 Mounting Bolts?  Cause we can, that's why"

I don't think it's realistics to detail every different toolhead assembly.  Perhaps we could make it more clear that M3x8 are for RevoVoron ONLY.

narf222, 2022-08-02:
thank you for your answers. and yes, there were 2 bolts M2.5 included with the dragon hotend, but not 4. And even those 2 were probably 6 instead of 8mm (haven't measured them, though)

Closed 2022-08-16.

Thread 22 (2022-08-01):

Probe Mounting Pass Thru on X-Carriage MGN9 vs MGN12

exiom-xyz, 2022-08-01:
`x_frame_V2TR_2xMGN9` carriage does not have the same wider pass thru hole which `x_frame_V2TR_MGN12` has and thus makes it incompatible with the Panasonic GX-H15A which is referenced on the BOM and the CAD file... as the hole pattern is just that tiny bit narrower...

Also a probe bracket does not exist for the Panasonic GX-H15A probe neither...

I had fixed the issue locally myself, but I thought this should be addressed upstream... thanks for all the hard work

Thread 23 (2022-08-01):

Minor SW X Carriage CW2 CAD Issue

ValuableToast, 2022-08-01:
SW X Carriage CW2 - 2 of the M3X40 bolts and their corresponding nuts are not centered in their hole.

Thanks!

wile-e1, 2022-08-18:
This issue has been taken care of and will be fixed in an upcoming PR.

Thanks for submitting the issue.

Closed 2022-08-18.

Thread 24 (2022-08-04):

Untracked design changes

GarthSnyder, 2022-08-04:
As of 5a2a1fd, there seem to have been minor modifications to the CW2 latch (relative to RC1) that are not mentioned in the logs and not reflected in STL changes. I didn't check other elements, just happened to be looking at the latch.

Is there a system in place to collect this information, or does someone have to manually go through and manually diff the whole design at the next release?

nemgrea, 2022-08-04:
could you be more specific? this is the current stl and an stl created from the current cad and im not seeing the modifications you are referring to
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

GarthSnyder, 2022-08-04:
Sure, here are some additional details. Just to be clear, I am comparing CAD/Clockwork2.stp from e6cc7d7 (aka RC1) with the same file as of the now-current HEAD, 5a2a1fd.

Here's a GIF animation showing the differences. It looks like this was intended as a clean-up, but it does modify the thickness of the struts in several regions.

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

Here are the CAD bodies superimposed in Fusion 360:

[Superimposed latches.f3d.zip](https://github.com/VoronDesign/Voron-Stealthburner/files/9262553/Superimposed.latches.f3d.zip)

nemgrea, 2022-08-04:
i guess I'm confused by what you are asking? is there a change that GitHub has not captured? or are you expressing the desire for a written list of changes beyond the commit history of the components?

GarthSnyder, 2022-08-04:
As a client of this repo that will be maintaining downstream mods, I would like to be able to find out whether parts of interest to me have changed. More broadly, everyone who prints RC1 is going to want to know what to reprint for the actual release. I worry that this information is getting lost in the shuffle.

Currently, the only way to determine changes is to manually import the STEP file into a CAD system and check each part by hand, every time there is a commit.

I guess that what I would really like to see is consistency between STLs and STEP. If the CAD is changed, the STLs should change. I don't actually care about the STLs themselves, but because they break everything out at the part level, they make it easy to determine what parts have changed between any two commits using git.

nemgrea, 2022-08-04:
ok we're back to talking about different things again here...you specifically showed a gif of stl to stl comparison and now your talking about a step to stl comparison?

i agree with you if there is a change to the cad then you should likely see a change to the corresponding stl file, only in very rare cases would this not be true, i believe we are in agreement here,

what im not following though is whether you observe an issue with the CURRENT stls vs the CURRENT steps?

im not sure why you are expecting RC1 files to be the same as the current files when you can see in the commit history that both the cad and the stls have hade newer files uploaded? if a new file is uploaded it can be assumed that it has changed, the extent of that change should be mentioned in the commit notes.

GarthSnyder, 2022-08-04:
> ok we're back to talking about different things again here...you specifically showed a gif of stl to stl comparison and now your talking about a step to stl comparison?

This is just getting silly. I don't know how to make it any more explicit than "Just to be clear, I am comparing CAD/Clockwork2.stp from https://github.com/VoronDesign/Voron-Stealthburner/commit/e6cc7d7b1d68a9c1707e0b089f6d283f2d530d41 (aka RC1) with the same file as of the now-current HEAD, https://github.com/VoronDesign/Voron-Stealthburner/commit/5a2a1fd0f86acc9204232f64b62abddbb71ca22a." The image obviously does not show STL bodies.

> what im not following though is whether you observe an issue with the CURRENT stls vs the CURRENT steps?

**YES**. The current STLs/Clockwork2/[a]_latch.stl file does match the CAD. That file has not been modified since RC1.

> im not sure why you are expecting RC1 files to be the same as the current files when you can see in the commit history that both the cad and the stls have hade newer files uploaded?

Some STLs have changed along with their CAD models and, in at least one case, others have not. Does this not seem like cause for concern?

nemgrea, 2022-08-04:
There have been a number of commits since the rc1 files have been released, that rc1 release you are linking is Not the current stl files.

The release is only current at the time it is posted. Once new commits are merged the release page is out of date until a new RC is put together

GarthSnyder, 2022-08-04:
OK, I give up.

nemgrea, 2022-08-04:
> >
> **YES**. The current STLs/Clockwork2/[a]_latch.stl file does not match the CAD. That file has not been modified since RC1.

WRONG!!

go here, open the latch.stl that is in the repository at this very moment
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
 look at the CURRENT latch stl file
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

now go here and download the CURRENT cad file for the CW2
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
 and see that it matches the previously viewed stl file..
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

you are using an OLD latch file from the RC1 zip that has been updated and at this very moment BOTH the cad and the stl for that latch are identical...

raymondh2, 2022-08-04:
The release has not been updated. It is time consuming to do one with a change log every time we change a file.

Closed 2022-08-04.

Thread 25 (2022-08-07):

V6 hot end problem

Ouxipi, 2022-08-07:
V6 CAD files with STL CW2 do not conform to the problem

raymondh2, 2022-08-07:
Please include more details.

wile-e1, 2022-08-15:
We are aware of the issue and it has been resolved.  The revised CAD models are going to be included in the next update.  The issue was that a feature in the master toolhead blank model caused features in the downstream model to become broken.......yay parametric CAD.

Thank you got bringing this to our attention.

Closed 2022-08-18.

Thread 30 (2022-08-17):

Cooling duct model error

BHoggs, 2022-08-17:
There appears to be a rogue triangle in the cooling duct of the revo mount, it's causing extrusions in mid-air when trying to slice/print

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

BHoggs, 2022-08-17:
Actually on closer analysis, it appears to be present on all of the cooling duct versions. It's present in the CAD models so it doesn't appear to be an export error

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

wile-e1, 2022-08-18:
This has all been taken care of and will be updated shortly

Closed 2022-08-18.

Thread 31 (2022-08-17):

Accent part not marked correctly

cactixxx, 2022-08-17:
STL part [a]_latch_shuttle.stl on page 15 is not marked as an accent part.

Closed 2023-05-05.

Thread 33 (2022-08-22):

Of note...

Durahl, 2022-08-22:
Ever since the Beta release of the SB / CW2 Combo I was having an issue that would creep in as time would pass, sometimes after weeks, sometimes during the first few prints where prints would fail because of the already high friction in my ERCF equipped System ( 1.5m Bowden Length ) causing the Filament getting stripped - With the general increase in room temperature during the summer this issue seems to have skyrocketed pretty much breaking the final straw in getting nice or even just finished prints at all.

Most of the time I could fix this by reprinting the Guidler, Latch, and Shuttle parts hinting at the issue being _somewhere_ in that region.

- With the release of the SB / CW2 CAD Solids I found confirmation that the Active Drive Gear was situated in the shadow of the Filament Path - The Passive Guidler Gear would thus constantly push the Filament into the side of the Filament Path of that of the Active Drive Gear introducing unnecessary ( and in my case additional ) friction.
Shifting all of the Geometry surrounding the Active Drive Gear 0.3mm ( like those of the Bearing Pockets ) towards the Guilder is sufficient enough to fix that - The Filament will no longer be pressed against the Sides of the Filament Path.

- Another MOD I had to perform was fattening up the Guidler and Latch Parts as I'm suspecting one or the other to suffer from creep under the constant load while working under hightened temperatures:
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
Fattening up the Guidler and Lever reduces the range of motion of the latter but won't actually impact the release of the Shuttle - The changes are also barely noticeable from an aesthetiv viewpoint but using these mods appears to have remedied most of the issues I've been dealing with over the last few days.

- Of note is also that performing an Interference Check between the `StealthBurner_Body` and a `Toolhead` will show a conflict on either side of the now Angled Areas that prevent the Partcooling Air from Escaping via the gap before it makes it from the Fan to the Toolhead.

nemgrea, 2022-08-29:
regarding the last note. ` performing an Interference Check between the StealthBurner_Body and a Toolhead will show a conflict on either side of the now Angled Areas`

have you perhaps assembled your cad without the appropriate gap seen below?

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

Durahl, 2022-09-08:
That part with the under extrusion looks like that _because_ I was having those issues - I just barely managed to print _that_ one as an unbent stopgap before settling with the fattened one - No other parts I printed after using the fattened one looks like that.

**Concerning the Filament Path:**
Original unaltered - best-case scenario CAD Model with a 1.75mm Filament added into the Filament Path.
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
Filament touching the Active Drive Gear side of the Filament Path - Can't go any further than that with the Filament Path present at the crosssection.

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
Filament BARELY touching the Active Drive Gear.

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
Perspective view of Filament BARELY touching the Active Drive Gear.

The CAD shows you either have BARELY ( yea I'm totally running with it... ) any contact with the Active Drive Gear or the Filament gets pushed like mad into the Side Wall.

And again, that is a best-case scenario... The Real-World Scenario will have the Filament Path be even smaller in Diameter only increasing the issue.

wile-e1, 2022-09-08:
The drive gears in the CAD are modeled with their drive groove incredibly deep.  Much deeper than what is typical in reality for BMG drive gears.  Their minimum diameter is Ø7.0mm while in actuality, gears are generally Ø7.4mm at the smallest part.  So what you're actually showing here is not entirely accurate.

CAD is always "best case scenario" and does not actually translate to reality.  The reality of the situation is that if this was indeed a systemic problem, nearly everyone should be seeing the same issues that you were seeing before your modifications.

Myself and many many others on the dev team have been through dozens of iterations on these parts pre-beta, beta, and rc1, and no one has pointed fingers at the design for issues or suggested there is a catastrophic design fault that needs addressing.  I have printed everything from TPE to CF-ABS with CW2 over the past year and results have been the best I have ever seen since I started printing, so forgive my reluctance to jump in and start changing fundamental design parameters.

raymondh2, 2022-10-10:
Closing due to inactivity

Closed 2022-10-10.

Thread 34 (2022-08-25):

Misnamed ADXL mounting bolts in CAD model

ForgeThrall, 2022-08-25:
The mounting bolts for the ADXL are named as M3x16_SHCS_1 in [Stealthburner_Assembly.stp](https://github.com/VoronDesign/Voron-Stealthburner/blob/main/CAD/Stealthburner_Assembly.stp), but when measured they are actually 12mm long. Checking irl, 12mm is indeed the appropriate length. The bolt length is never stated in the manual.

wile-e1, 2022-09-07:
This will be corrected in the next update.  Thank you.

Autodesk Inventor is giving me a ton of grief when exporting to STP files.

Closed 2022-09-28.

Thread 35 (2022-08-25):

STL is wrong

cryd-s, 2022-08-25:
STLs/X_Carriage/x_frame_V2TR_MGN12_left.stl

the passage for a screw is missing here it also affects the other side

MaximeLambrechts, 2022-08-26:
Are you refering to the screws that mount the extruder to the carriage? These holes now accept heatset inserts and the extruder is now mounted from the front. Have a look at the manual :)

cryd-s, 2022-08-26:
Ah ok - thats terrible for lgx users :(

MaximeLambrechts, 2022-08-26:
This mount works well with the new carriage : https://www.thingiverse.com/thing:5242645

Closed 2022-08-26.

Thread 37 (2022-09-04):

Wrong bolts length for tool cartridge in the manual

bistory, 2022-09-04:
Hi,

I followed the manual, everything looks good except for one step for the tool catridge (page **41**).
The manual tells to use M3x12 bolts but they won't fit.
It should be M3x14 (tried that, it works) or M3x16 (didn't try that but it should work, based on CAD).

Thanks for the hard work !

BerzerkaDurk, 2022-09-05:
I checked the toolhead models for all of the hotends, and the distance from the bottom of the counterbore to the opposite side of the rear mount is 10.5 mm on all of them, so a 12 mm screw should work fine.

Any chance your heatsets for those 2 screws are set below the surface of the front mount?

BerzerkaDurk, 2022-09-05:
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

bistory, 2022-09-05:
> 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

Thanks for your check but it's not the same hole ^^

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

BerzerkaDurk, 2022-09-05:
That _is_ the right hole. It's the only hole with the hardware on the page you mentioned. Page 41

The way you are measuring shows the max depth the screw can go.

The way I'm measuring shows how much of the screw extends past the rear half. If the counterbore is 10.5 mm from the other side of the rear part, a 12 mm screw will extend 1.5 mm past and into the heatset in the front part. It's pretty basic.

bistory, 2022-09-05:
Ok strange then because my inserts are not 1.5mm below the surface...
I will check if my screws have the correct size

BerzerkaDurk, 2022-09-05:
Probably wouldn't hurt to change them to 14s anyway. Rule of thumb is usually 1 diameter of thread engagement minimum, and 1.5 mm only gives you 1/2 of a diameter.

wile-e1, 2022-09-07:
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

We won't be changing the bolt length to M3x14 because it is not a standard size in our Voron category of parts.

M3x12 work ok because the plastic under the head of the bolt compresses some when the screw is tightened.
M3x16 also works because there is clearance on the other side of the insert to allow the screw to protrude past the heatset.

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

bistory, 2022-09-07:
Thanks for your reply @wile-e1 , I have checked again M3x12, it fits, now that the counterbore holes have been "done" by longer screws. The screws measure 12mm with no extra, the printer is correctly calibrated. I had no problem with other screws.

I think M3x16 wouldn't hurt because those pieces are not meant to be disassembled regularly...

Here is some pictures of how it fits with M3x12 :

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

Closed 2022-10-10.

Thread 38 (2022-09-17):

Bom part count missing 1 M3x6 FHCS

Blinker73, 2022-09-17:
The bom says 2 are needed but the manual says 3 are needed.

1 for the filament tensioner max travel screw
2 for the part cooling fan

nemgrea, 2022-09-22:
change has been submitted

Closed 2022-09-22.

Thread 39 (2022-09-22):

No extrusion or move

rainerschulte, 2022-09-22:
On my Switchwire I had to replace my Afterburner and have a Stealthburner almost ready except for the Front.
I connected the LDO NEMA 14 to the Extruder but get no move on the inserted Filament. What coud it be?

raymondh2, 2022-09-22:
Please try our Reddit page or Discord server for support. We use GitHub for managing design issues and support questions tend to go unanswered. https://vorondesign.com/ under community

Closed 2022-09-22.

Thread 40 (2022-09-22):

BOM/Sourcing Guide observations

subatomicglue, 2022-09-22:
- [The Sourcing Guide](https://vorondesign.com/sourcing_guide?model=VSB) has a lot of empty cells, will it be updated at some point?
- In the [BOM](https://vorondesign.com/voron_stealthburner) the “Complete BMG Extruder Clone” link is dead at aliexpress (other link works) `Sorry, the page you requested can not be found:(`
- [The Sourcing Guide](https://vorondesign.com/sourcing_guide?model=VSB)'s “ADXL Optional” is not listed on the BOM (should it be?)
- I assume “ADXL Optional” is the ADXL 345 from google searches on it...  something like this?   https://www.amazon.com/Adafruit-ADXL345-Triple-Axis-Accelerometer-ADA1231/dp/B01BT4N9BC     or this (~6x cheaper)?   https://www.aliexpress.com/item/3256803808631787.html   many ADXL boards seem to have different form factors slightly...  how to choose, or identify what’s compatible?
-  [The Sourcing Guide](https://vorondesign.com/sourcing_guide?model=VSB)'s  Neopixel was missing links for sourcing, here's some I found:
  - https://www.aliexpress.com/item/3256804089586600.html
  - https://www.aliexpress.com/item/3256804145533673.html
  - hahah rainbow barf neopixels: https://kb-3d.com/store/printer-specific-harnesses/566-6854-rainbow-barf-led-toolhead-harness-for-stealth-burner-1653783045189.html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
- BOM/Sourcing:   Hotends you recommend for the proper stealthburner experience would be nice to see listed.
  - Is there a place where their merits and detriments are compared/discussed in a doc in re: to stealthburner?  The [README.md](https://github.com/VoronDesign/Voron-Stealthburner/tree/main/STLs/Stealthburner/Printheads) only has notes, but no guide to selecting them…
    - Might be nice to link to this from the BOM/Sourcing guide to help people make their decisions...

Hope this helps RC1 get to Release :)   And I hope appropriate as a github issue :)

RealDeuce, 2022-10-11:
Just to add my two cents, the Amazon initeq inserts are really too big for the two heatsets by the big gear, I tried using them and had to cut the bulges off by the gear afterward.  The bottom one without the cutout was the worst, the heatset body actually extends past the edge even when it's cut back.

aeiounix, 2022-10-13:
> initeq inserts are really too big
Or the holes are too small. OR holes are too big for the smaller inserts. I saw a related issue on the afterburner repo. The inserts that came with the insert tool I bought are too small for the holes. I figured this is one of those "we're all just people" type issues and I'm gonna push ahead and make it work or try again if it doesn't.

subatomicglue, 2022-10-13:
I haven't used my amazon initeq M3-0.5 heatsets yet...   but here's a picture:
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

subatomicglue, 2022-10-13:
For heatset inserts,  The stealthburner PDF manual links to the [The Voron sourcing guide](https://vorondesign.com/sourcing_guide), which lists :
```
M3 Brass Heatset Inserts - Short M3x5x4
```

And gives the following links for `M3xD5xL4`:
- [Aliexpress](https://www.aliexpress.us/item/2255800046543591.html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)
- [Aliexpress](https://www.aliexpress.us/item/2255800046543591.html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)

Measuring my heatset inserts [initeq @ Amazon](https://www.amazon.com/gp/product/B077CJV3Z9/ref=ppx_yo_dt_b_search_asin_title?ie=UTF8&th=1), I get: `M3 L3.8 D5.5`, which does NOT match the sourcing guide's spec.

I'll add this to my list in the OP...

BerzerkaDurk, 2022-10-13:
Yes. The inserts in the Amazon link are very clearly NOT the correct insert. Somebody goofed the link.
Just checked the McMaster-Carr link, and those are incorrect as well.
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

Thread 41 (2022-09-22):

[Firmware] Comment about RGB and RGBW not able to be mixed in same chian is no longer accurate

ChaosBlades, 2022-09-22:
> Note: RGB and RGBW are different and must be defined explicitly.  RGB and RGBW are also not able to be mix-and-matched in the same chain. A separate data line would be needed for proper functioning.

Support for this was aded for the Rainbow Barf mod
https://github.com/tanaes/whopping_Voron_mods/tree/main/LEDs/Rainbow_Barf_Logo_LED
Here is the pull request
https://github.com/Klipper3d/klipper/pull/5409

Thread 42 (2022-09-22):

[Firmware] Add delayed_gcode section to turn on Stealthburner LEDs on Printer Boot

ChaosBlades, 2022-09-22:
```
[delayed_gcode sb_leds]
## STATUS_READY
initial_duration: 1
gcode:
    _set_sb_leds_by_name leds="logo" color="standby" transmit=0
    _set_sb_leds_by_name leds="nozzle" color="standby" transmit=1
```
Not sure if you would want to implement this in this way but some kind of section like this should be added at least in a commented out manner.

nemgrea, 2023-05-05:
why is a delay beneficial? (i dont use those LEDs just looking for explanation)

Thread 43 (2022-09-25):

Stl filenames with the _SW suffix

StevensStuff, 2022-09-25:
I've been noticing a lot of people asking questions on Discord what the _SW means in the file names.  For example STLs/Clockwork2/chain_anchor_2hole_SW.stl

Can we either change the suffix to _Switchwire and/or add that suffix to the Readme.md in the STLs/ folder for Filename Nomenclature?

bythorsthunder, 2022-09-25:
I think this is a good idea. The SW acronym seems to be very confusing to newcomers who may not even be aware the Switchwire is a Voron printer.

DT27, 2022-12-26:
>

it's me! I have to search "SW" and "Switchwire" to find out that!

Closed 2023-01-02.

Thread 44 (2022-10-04):

wrong M3x6 FHCS count at BOM

LuckyTurtleDev, 2022-10-04:
https://vorondesign.com/voron_stealthburner tells me I need 2 M3x6 FHCS screws for the stealburner.
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
But I count 3 at the manuel:
* 1 x [page20](https://raw.githubusercontent.com/VoronDesign/Voron-Stealthburner/66831c984ab8d9dfe8dfd114ca31e2aa4bee8c35/Manual/Assembly_Manual_SB.pdf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)
* 2 x [page65](https://raw.githubusercontent.com/VoronDesign/Voron-Stealthburner/66831c984ab8d9dfe8dfd114ca31e2aa4bee8c35/Manual/Assembly_Manual_SB.pdf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)

nemgrea, 2022-10-10:
fix has been submitted

Thread 45 (2022-10-04):

M3x6 FHCS (anit squish thingymajig) needs threadlocker to prevent coming loose over time

pajtaz, 2022-10-04:
In the Stealthburner assembly manual there is no mention of using threadlocker to secure the M3x6 FHCS used for anti squish thingymajig. Multiple people have reported that screw coming loose over time, including myself. Using threadlocker on this screw should prevent the bolt from coming loose.

I suggest to add a note to use threadlocker when installing this screw. It can be done on page 20 and/or 27 of the assembly manual.

BerzerkaDurk, 2022-10-04:
I put Loctite 222 on mine. Bought it specifically for this application.

LuckyTurtleDev, 2022-10-04:
With FHCS did you mean? The screw on [page 20](https://raw.githubusercontent.com/VoronDesign/Voron-Stealthburner/66831c984ab8d9dfe8dfd114ca31e2aa4bee8c35/Manual/Assembly_Manual_SB.pdf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) or the both on [page 56](https://raw.githubusercontent.com/VoronDesign/Voron-Stealthburner/66831c984ab8d9dfe8dfd114ca31e2aa4bee8c35/Manual/Assembly_Manual_SB.pdf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)?

BerzerkaDurk, 2022-10-04:
>

There's a clue in the title.

LuckyTurtleDev, 2022-10-04:
ups i am stupid

nemgrea, 2023-05-05:
https://github.com/VoronDesign/Voron-Stealthburner/pull/88

Closed 2023-05-05.

Thread 47 (2022-10-05):

[BOM] Missing M3 Washer

FatalBulletHit, 2022-10-05:
On p. 29 of the manual a M3 washer is required, while present in the sourcing guide, this is missing from the BOM.

nemgrea, 2022-10-10:
fix has been submitted

Closed 2022-10-10.

Thread 48 (2022-10-07):

Underextrusion

bartoszwas, 2022-10-07:
Hey all,

My issue is I am unable to get rid off underextrusion. I calibrated Extruder rotation distance, then I calibrated flow rate and lastly pressure advance. No matter what I do every print is underextruded, some more some less...

Finally I changed guilder parts by 1 mm to make extruder gears closer and no underextrusion issues.

raymondh2, 2022-10-07:
Please try for support on our community pages listed on vorondesign.com We use GitHub for keeping track of issues not troubleshooting help

bartoszwas, 2022-10-08:
It is issue since beta.
https://github.com/VoronDesign/Voron-Afterburner/issues/132

Thread 49 (2022-10-07):

E3D V6 stringing

tekgamerpt, 2022-10-07:
Hello
I've been testing stealthburner with a V6 mostly printing PLA. Already tweaked temperature, retraction, retraction speed, etc and still having problems with stringing.
It seems that air flow not going directly to the nozzle point direction.
Anyone with similar problems or am i missing something?

Cheers and keep up the good work

raymondh2, 2022-10-07:
Please try for support on our community pages listed on vorondesign.com We use GitHub for keeping track of issues not troubleshooting help

Closed 2022-10-07.

Thread 50 (2022-10-07):

Pg 23 of manual, words unclear

subatomicglue, 2022-10-07:
On Page 23 of the [voron stealthburner manual](https://github.com/VoronDesign/Voron-Stealthburner/raw/main/Manual/Assembly_Manual_SB.pdf)

We see:
```
DON’T OVERTIGHTEN
Tighten until the plastic bends and cracks.
Back up 2 turns, discard parts, reprint and try
again.
```

This language seems confusing to me.
1.) it tells me to not over tighten.  ok.  got it!
2.)  it then tells me to tighten until I bend and then crack the plastic.    (what?  this sounds bad)
3.)  then it tells me to back up 2 turns (turn the screws in reverse by...   how much?   2x  360deg rotations?)
4.) and to then reprint and do this again. (was I supposed to remember the position of the screw for next time?)

it sounds like i need sacrificial parts, and that cracking my parts is part of calibrating the screw tightness or something.

If I had to rewrite this, I would say instead:
```
DON’T OVERTIGHTEN
If you bend or crack the plastic, discard parts, reprint and try again.
```
Which is much more clear.

Or, in the scenario of calibrating your tightness using sacrificial parts, I'd say something more like this:
```
DON’T OVERTIGHTEN
Have 2 sets of parts ready, one is sacrificial:
Tighten until the plastic bends and cracks.
Back up 2 turns (360deg each turn), note the screw depth, discard parts,
reprint and screw to the previously found depth.
```

As it is now, I can't tell what is being asked.  But I'd default to not cracking my parts if possible.  :-)

raymondh2, 2022-10-07:
It's a joke. Not actually directions

subatomicglue, 2022-10-07:
maybe needs a `(kidding!!)` after the writing?  I was baffled.  haha

BerzerkaDurk, 2022-10-07:
🤦‍♂️

Closed 2023-01-24.

Thread 51 (2022-10-10):

Belt clamp Switchwire orientation

Grooviee, 2022-10-10:
I think the orientation of the [a]_Belt_Clamp_SW_x2.STL is wrong and should be rotated the same as the [a]_xz_belt_clip_x2.stl in the Switchwire-github.

nemgrea, 2022-10-11:
https://github.com/VoronDesign/Voron-Stealthburner/pull/52

Closed 2022-10-11.

Thread 53 (2022-10-28):

X_Carriage don't have hall effect endstop

sad1ce, 2022-10-28:
Default X_Carriage from Voron2.4/Trident have place for hall effect endstop, is it possible to add it to Stealthburner X_Carriage ?

BerzerkaDurk, 2022-10-28:
The one I printed has one...
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

sad1ce, 2022-10-28:
Yes, i checked it. I thing SB manual should have explain this, like in Voron2.4/Trident manual.
Someone, who build Voron2.4/Trident with SB from scratch, will likely use SB manual for X_Carriage assembly, like i did ;) and will not notice reference to original manual.

Closed 2022-10-28.

Thread 54 (2022-10-29):

Rename chain anchor to cable bridge or update documentation.

aeiounix, 2022-10-29:
Does this warrant a pull request?

Page 31 of the assembly manual reference cable bridge. Tripped me up. If it's just me, close this issue. But if we think other people might stumble on this it's a simple fix, which is the real focus of this issue.

nemgrea, 2023-05-05:
https://github.com/VoronDesign/Voron-Stealthburner/pull/88

Closed 2023-05-05.

Thread 55 (2022-10-30):

SB-CW2-Motorplate: Two Threaded-Insert-Holes seem to have the wrong Orientation

Hanniballus, 2022-10-30:
Hey,

I am currently building a Stealthburner and it seems to me like two Holes for Threaded Inserts int he CW2-Motorplate need to be "Reversed".

As they are, the Inserts are on the same Side as the Screw resulting in the Insert beeing easily pulled out when to much force is applied. To me, someone not proficient in Product Design, this seems odd, as the Holes could be easily Reversed so that the Insert is on the Opposite Side as the Screw and thus needs to be pulled through the whole Part to be pulled out.

I have made some Screenshots of the Current Version and the Overhauled Version which I frankensteined together.
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

Primarily I'm just curious as to why the Holes are Oriented that way.

Kind Regards

Pedda

Thread 56 (2022-11-05):

Undersized counterbore in Stealthburner_Printhead_Dragon TH front part

BluePaci, 2022-11-05:
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

Should be at least 5.5mm for M3 SHCS (if anything, 6.0, to account for flattening at the top)

Regards, Blupaci

BluePaci, 2022-11-05:
Was mistaken

BerzerkaDurk, 2022-11-05:
Might have something to do with the fact that those holes are meant for M2.5 screws...

Closed 2022-11-05.

Thread 57 (2022-11-16):

F3d cable door

BOAndy1985, 2022-11-16:
Hello I would like to edit the  for the SB because this no longer fits due to the heat sink of SB2040 where can I get the file

raymondh2, 2022-11-19:
Steathburner was not designed in Fusion360. As such there is not F3D file. Please use the STEP file provided inplace.

BOAndy1985, 2022-11-19:
With which program was it designed if I may ask

Closed 2022-11-19.

Thread 58 (2022-11-23):

The stealthburner manual says to use M3 bolts when M2.5 bolts are correct

oernster, 2022-11-23:
Page 42 of the stealthburner manual says to use M3x8 bolts.  a) the holes are not big enough and b) they do not fit a dragon high flow hotend.  Also, the dragon high flow hotend needs to have the top piece removed which is not mentioned in the manual at an earlier point in the manual.

For me, I heat setted M3x8 bolts and THEN discovered that the hotend didn't take the bolts and completely damaged the parts trying to heat remove them.  Now I've had to resource the parts and I've learned the hard way that M2.5x8 is ACTUALLY required.

Please can you address this in the manual.

oernster, 2022-11-23:
OK, so let's clarify, perhaps the manual was accurate but perhaps the manual ought to indicate a dragon high flow as an option.  OR say careful the bolt sizes are only for the revo.

BerzerkaDurk, 2022-11-23:
>  OR say careful the bolt sizes are only for the revo.
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

Kosh42, 2022-11-25:
You heat what the bolts? 🤨

raymondh2, 2023-01-02:
Manual already addresses other hotends needing other size bolts

Closed 2023-01-02.

Thread 59 (2022-11-30):

Rapido Hotend Rear fit for Tap

Dr-Info, 2022-11-30:
Discord user: Hagbard#7867 discovered an issue with the rapido_rear_cw1 and rapido_rear_cw2 mounting to Tap. The hotend couldn't sit flush due to the BHCS on TAP, see Link 1. Hagbard moded the rear mounts and pinned it in Voron_Tap, see Link 2.

Link 1: https://cdn.discordapp.com/attachments/1041007230239125574/1047294839181557800/unknown.png
Link 2: https://discord.com/channels/460117602945990666/1041007230239125574/1047298344680165466

nemgrea, 2023-01-24:
https://github.com/VoronDesign/Voron-Stealthburner/pull/74

Closed 2023-01-24.

Thread 61 (2022-12-14):

E3D-V6 CAD

dabaiyyds, 2022-12-14:
I need E3D-V6 air duct model CAD file, thank you!

BerzerkaDurk, 2022-12-14:
CAD/Printheads/Stealthburner_Printhead_V6.stp ?

dabaiyyds, 2022-12-14:
thanks, i found it

------------------&nbsp;原始邮件&nbsp;------------------
发件人: ***@***.***&gt;;
发送时间: 2022年12月14日(星期三) 下午3:53
收件人: ***@***.***&gt;;
抄送: "不爱@又何必@***@***.***&gt;; ***@***.***&gt;;
主题: Re: [VoronDesign/Voron-Stealthburner] E3D-V6 CAD (Issue #61)

CAD/打印头/Stealthburner_Printhead_V6.stp ？

—
直接回复此邮件，在 GitHub 上查看，或取消订阅。
您收到此消息是因为您创作了该线程。消息 ID：<VoronDesign/Voron-Stealthburner/issues/61/1350573803 @ github 。com&gt;

Closed 2022-12-14.

Thread 62 (2022-12-16):

Carriage Manual S.61 Wrong Length Bolts

thomasfjen, 2022-12-16:
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

Manuals says M3x30, i had to use M3x40. CAD also measures 40mm.

jonesuki, 2023-01-30:
On my MGN12 X-carriage, I can confirmed that M3x30 SHCS is long enough. I checked the STL files and the actual screw length required is about 27.x mm (because the hex bolt actually "sinked" inside the printed parts.
I discovered this because I accidentally installed M3x40 SHCS and both screws sticked out. The bottom one even triggered the X-endstop a few mm too soon.

raymondh2, 2023-01-30:
Screws are both 30mm. Manual is correct.
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

thomasfjen, 2023-01-30:
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
You guys are correct, i was referring to the switchwire carriage and oversaw that this already covered in the switchwire manual.

raymondh2, 2023-01-30:
Ah it's the switchwire carriage. We should make note of this in the Stealthburner manual.

massis87, 2023-04-27:
The Trident manual actually mentions a 40mm bolt, which was so long in my case that it stuck out on the right side. I had to change it to a 30mm.

nemgrea, 2023-05-05:
https://github.com/VoronDesign/Voron-Stealthburner/pull/88

Closed 2023-05-05.

Thread 64 (2022-12-28):

the accent naming should be swapped with accent color

cnnblike, 2022-12-28:
I just realized that the "[a]_stealthburner_main_body" of stealthburner is printed in accent color according to the naming schema, this makes the printed Stealthburner looks primarily in "accent" color (especially from the front view) - that make this naming bit confusing.

raymondh2, 2022-12-28:
The front is an accent color. Base VS Accent naming is based on V2.4/Tridents Accent/Base scheme

Closed 2022-12-28.

Thread 66 (2022-12-29):

Too thin wall on SB front results in artifacts

Gizzzle, 2022-12-29:
I tried to print the release version of the SB front but kept getting the artifacts shown in the picture beneath. This is the result of the walls being too thin to fit more than 1 perimeter and the gap fill showing through.

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

The issue is cause by this little edge which has in my eyes no reason to be here.

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

Deleting the facet make the whole wall a bit thicker and results in a far better quality.

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

raymondh2, 2023-01-02:
@Badnoob-327 @wile-e1

Thread 68 (2023-01-04):

trapped heat causing melt distortion issues for some users

Badnoob-327, 2023-01-04:
Some users have been experiencing melted carriages when using stealthburner

It may be limited to Dragon hotends (or it may not)
It happens even when using a sock.
It happens on a variety of ABS filaments.

I'm going to try and run a few experiments to confirm/quantify the issue, and then work on some fixes.

If you've had an issue where the M3x50's have pulled out their heatsets, this is the place for you. to post pictures of what you observed.

Badnoob-327, 2023-01-04:
from discord user "Carlos Diegues"
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
this appears to show significant and uniform deformation in Z

Badnoob-327, 2023-01-04:
from discord user"Pajtaz"
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

ScottSmall, 2023-01-04:
Tap bhcs shelf contacts, mediocre print to start with. Dragon ST, ~100h, socked, at 250-260
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

ScottSmall, 2023-01-04:
Tap bhcs shelt contacts, 200h Dragon HF, 260-270, socked, kvp brg likely printed at 250 (yes, with elephants foot). In both cases, the A side resting lug is a little more warpy.
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

pajtaz, 2023-01-04:
Stealthburner with Rapido and Tap. After roughly 100 hours of printing in 50 to 60 deg C chamber, printing one filament at 245 for 60-70 hours, and another filament at 260 for 20-25 hours, Tap Center and Tap Front softened. Photos are attached. Filament was FormFutura TitanX printed at 250 with Voron V0.1.
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

pajtaz, 2023-01-04:
After many hours printing in 50+ deg C chamber with Dragon HF, filaments with print temp ranging from 245 to 265, there were multiple softened X carriages and rear hotend mounts. Both were printed with 3 different filaments: TitanX (ABS+), ApolloX (ASA), EasyFil ABS (I guess just ABS, maybe slightly altered, should have softening temp at 103).

Softened X carriage, softened rear mount - 2 times since before 13/05/2022 (mentioned already on 23/04/2022)

After this happened, modified PRINT_START routine to move toolhead during soaking to max Y location, 100 mm above the bed, turn part cooling fan to 100%, and hotend to 50 deg C during heat soaking.

It did not help. Eventually both X carriage and rear hotend mount softened. Unfortunately I do not have a photo of softened X carriage but it was always softening at the bottom where the 2 M3x50 bolts are threaded. It was softening towards the center.

Eclypse3D, 2023-01-07:
Hatchbox abs printed @250c.  Chamber temp  is around 50-55c normally while heat soaked.  About 200hrs printing.  Had to retighten center rail 4 times already and as time went on started getting x axis waves in prints and now also lines on the Z, which I have already gone over everything.  I have replaced printed parts today will monitor most not all the waves are gone, lines have persisted.  Never had lines like these before..

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

Badnoob-327, 2023-01-08:
> Hatchbox abs printed @250c. Chamber temp is around 50-55c normally while heat soaked. About 200hrs printing. Had to retighten center rail 4 times already and as time went on started getting x axis waves in prints and now also lines on the Z, which I have already gone over everything. I have replaced printed parts today will monitor most not all the waves are gone, lines have persisted. Never had lines like these before..
>
> 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

what hotend are you using?

Badnoob-327, 2023-01-08:
> Stealthburner with Rapido and Tap. After roughly 100 hours of printing in 50 to 60 deg C chamber, printing one filament at 245 for 60-70 hours, and another filament at 260 for 20-25 hours, Tap Center and Tap Front softened. Photos are attached. Filament was FormFutura TitanX printed at 250 with Voron V0.1. 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

the fact that this is also happening for Rapido for you tells me there may be something else contributing to it, as Rapido's mount does allow some airflow
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

pajtaz, 2023-01-08:
I will update tomorrow after another inspection of Tap and hotend mount but I think the Rapido mount is already warping. Give me until tomorrow and I will provide photos.

Badnoob-327, 2023-01-08:
the fact that you are getting warping all the way to the center part of tap indicates this likely isn't something we can fix with a design change to SB ducts.  Most likely you'll have to either reduce chamber temp or find a material that can withstand your higher temperatures.

pajtaz, 2023-01-08:
>

I do not want to change chamber temps. It is ok if it is not possible to alleviate this problem, as long as that is agreed. I can then focus on printing some of those parts out of a different filament.
I will report back in a few days anyway to document if any Tap parts or Rapido rear hotend mount have warped since I last printed them.

Eclypse3D, 2023-01-08:
I am running the Revo Voron, which has been doing well till after I installed TAP.  Everything was been relatively fine, then about a week after I started seeing changes in prints, then it seemed like no matter what I did I started getting off prints that I never got before, my stacks used to be mint, no lines, no waves, no patterns....  Then I started noticing there was a noticeable amount of X axis play about .5mm and I disassembled everything and found that the center rail was loose.  I snug that down and a week later same thing, so I pulled it all off and found it was warping.   (To be fair I was printing alot of ABS over the past few weeks so chamber temps were at a constent.  (I also noted the rear hotend mount where it meshes with the front on the right side had flared outward too.

I have completely rebuilt TAP using the supplied printed parts from Fabreeko and the wavy part is way reduced, I can still just kinda see it but....  I replaced the 50mm rail and well so.

Right now its running ok, but the print quality is not what it was, and I have already tore everything down to the belts, and re-racked etc.  Everything is tight, and all steps are what they should be.

I have a rapido coming tomorrow..  So I will be recalibrating and installing a complete new print head...(all printed parts etc.  Including extruder is rebuilt.)

Eclypse3D, 2023-01-08:
>

I am running the Revo Voron, which has been doing well till after I installed TAP. Everything was been relatively fine, then about a week after I started seeing changes in prints, then it seemed like no matter what I did I started getting off prints that I never got before, my stacks used to be mint, no lines, no waves, no patterns.... Then I started noticing there was a noticeable amount of X axis play about .5mm and I disassembled everything and found that the center rail was loose. I snug that down and a week later same thing, so I pulled it all off and found it was warping. (To be fair I was printing alot of ABS over the past few weeks so chamber temps were at a constent. (I also noted the rear hotend mount where it meshes with the front on the right side had flared outward too.

I have completely rebuilt TAP using the supplied printed parts from Fabreeko and the wavy part is way reduced, I can still just kinda see it but.... I replaced the 50mm rail and well so.

Right now its running ok, but the print quality is not what it was, and I have already tore everything down to the belts, and re-racked etc. Everything is tight, and all steps are what they should be.

I have a rapido coming tomorrow.. So I will be recalibrating and installing a complete new print head...(all printed parts etc. Including extruder is rebuilt.)

Badnoob-327, 2023-01-08:
We tested this using 50-60C chamber temps at 23 hour/day print cycles, on 8 printers, for weeks though.  and none of those printers experience rail loosening or part warping.  Revo Voron is just about the best hotend we tested in terms of low waste heat.

Its a mystery.

Eclypse3D, 2023-01-08:
> We tested this using 50-60C chamber temps at 23 hour/day print cycles, on 8 printers, for weeks though. and none of those printers experience rail loosening or part warping. Revo Voron is just about the best hotend we tested in terms of low waste heat.
>
> Its a mystery.

The variable here is obviously the filament.

Badnoob-327, 2023-01-09:
theres other variables too.  thermistors can be off by as much as 10%, and aren't recording conditions away from the sensor.
operating procedures vary, for example preheating at Z=0 with fan off is different from preheating at Z=50 and 100% fan.
and others.

pajtaz, 2023-01-09:
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
After about 75 hours of printing in same conditions as before, rear hotend mount of Rapido warped. I attached a photo. This one was printed out of FormFutura Easy Fil ABS, which has a higher softening temperature than TitanX.

Tap parts printed out of same material did not warp this time.

paulsgale, 2023-02-03:
I have also experienced this twice now. The first time was a little while after I first built my 2.4r2, just as r2 was being released. I posted pics to discord but not sure if I have them here.
Yesterday, I decided to perform some maintenance and removed the SB to check what I had noticed as a slight variation in my z height caused I think by a shift in the nozzle. I discovered that the heatset inserts had once again been pulled from their holes as the X carriage has softened and warped slightly.

After the previous exact same issue, I was really careful not to over tighten the lower long screws, just pinching them tight but no more. It would seem that just from printing and the stresses that these have pulled free. I’ve not had any nozzle strikes and my printer is very finely tuned and looked after.

Someone mentioned that some Formbot kits had been supplied with incorrect heatset inserts but I’ve just measured the two that have failed and they are perfectly in spec (M3x5x4)

It would help if the inserts could be mounted on the back side of the x carriage although I realise this would require even longer screws and might get in the way of other fastenings.

My specs:
2.4r2 300mm
Parts printed from TitanX ABS (very good quality prints)
Heatset inserts seemed to fit well and were done with a heatset tool on my weller temperature controlled soldering iron (only hot enough to fit, no more)
Total printer hours since built - 261hrs
I print mainly eSun ABS+ at 240/250C
250C is the hottest I’ve ever printed
Chamber is at 42C max after several hours, no higher
Bed at 110C

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

paulsgale, 2023-02-03:
Oh, this is one of the heatset inserts that came loose. Measured with my digital calipers and seems in spec. Certainly exactly the same as another batch I bought from a different supplier.
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

paulsgale, 2023-02-03:
One question though - the heatset insert hole is 10mm deep but I’ve fitted them flush to the surface. It might be that if I fit them deeper, this might help as they have 5mm extra clearance away from the heat source. Maybe that won’t make any difference though. Any thoughts on this?

paulsgale, 2023-02-05:
I stripped the print head today and fitted a newly printed x carriage. On inspection, I did find a fair bit of warping to the rear of the hot end mount too (sorry, forgot to take pictures but can get then if really needed).
I guess the question is - why aren’t more users seeing this or is it that they aren’t stripping down very often and just don’t notice? Or is it that it’s purely something we’re doing?

my print head always parks about z=15mm rear left so can sit there for some time while heat soaking and before/after prints. Is the environment just too warm and maybe other users have different holding locations and positions? I’ve adjusted my macros to give a lot more distance from the bed and will see if that helps.

One other question - would running the part fan at a low level help while heating/waiting etc? Does the part fan airflow even get up into the areas affected at all r is that purely the HE fan?

Badnoob-327, 2023-02-06:
you should have your part fan on during heatsoak. and we suggest more space than 15mm, 30-50 would be better.

pgale, 2023-02-06:
I'll modify my macros - I've already increased the height during heat soak. Does it matter what fan percentage or rather would you recommend a minimum?

pajtaz, 2023-02-06:
Keep it simple: run the part cooling fan at 100% when you are soaking and set the hotend to something like 60 C so the hotend fan runs also. Move the toolhead 100 mm above the bed.

This will not eliminate the issue. Eventually there will be softening due to the heat being trapped there while printing in a hot chamber. However it can help reduce the softening that happens during soaking.

pgale, 2023-02-06:
Thanks. Will do that.

Gi7mo, 2023-04-01:
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
dragon hotend, after less then 100 hours of print
heatsoak happens behind the bed 15mm above the purge bucket
my afterburner carriage was deformed too, but not that bad and after hundreds of print hours

ekhaliul, 2023-05-24:
I am seeing some melting as well. In my case the heat inserts would fall out when taking things apart. More pics here as well https://imgur.com/a/9kWMeLz. (following up from this thread [reddit](https://www.reddit.com/r/VORONDesign/comments/13pdzxg/is_there_a_fix_for_falling_out_threaded_inserts/))
I have enclosed chamber with 40-45C inside during print. Also print with heated bed @100C. I mostly print PLA/ABS/PETG with hotend temp 260C max, Mosquito hotend.
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

Badnoob-327, 2023-05-24:
> ith 40-45C inside during print. Also print with heated bed @100c. I mostly print PLA/ABS/PETG with hotend temp 260C max, Mosquito h

Mosquito pumps out a lot of heat. What kind of plastic is that printed out of? ABS? ABS+? what brand?

ekhaliul, 2023-05-24:
This was printed with ABS, hatchbox brand.

Good point about charring. I am running nevermore inside enclosure, but I will need a more comprehensive solution to prevent charring in the first place.

joaquinabian, 2023-06-03:
Got problems. Inserts are also loose.
Only a few printing hours (25 max) at 250-255/110, chamber between 45-55.
Dragon HF + CW2 at 250 mm/s 0.4 nozzle, voron settings
The parts are PIF, printed on TitanX for a Trident 300.

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

pfielding, 2023-07-03:
I had the heatsets pop on my carriage twice now.  I don't have photos of it pre-fixing unfortunately, though if it happens again I'll definitely take a couple of shots before doing anything.  The carriage itself seems mostly fine, it's just the two heatsets that hold the lower front plate through to the carriage that came loose.    Running a Dragon HF, the heatbreak fan seems to be pushing good air.   I mostly print ABS at about 250/110, with a chamber that sits around 58-60.

CrappyGamingXD, 2023-07-05:
Running dragon hf and yep, I'm getting this issue. Pretty bad too, my heat sets dont stay in for long. Would like to see a fix of some sort if possible.

TuningJohn, 2023-09-15:
We have experienced the same issue several times now. The threaded inserts become loose and pull out, causing the toolhead to become floppy.  We have used a couple different threaded inserts at this point, the last try used a longer version than the stock ones. We made sure to keep the inserts flush with the carriage mount front surface, but it still failed while running a Dragon HF around 250 C. Internal chamber temps are around 42 C.

## Root cause:
The threaded inserts are too close to the hot end and the plastic around them loosens. The vibration from toolhead movement causes the joint to become loose, the inserts eventually pull out, and printing become unreliable.

## Recommended fix:
In my opinion, no change in the threaded inserts will fix the problem, they must be relocated somewhere further away from the hotend. My first thought was to use longer screws and put the threaded inserts (or just a nut) on the _back_ side of the carriage mount part rather than the front. The hole for these two screws will go all the way through the part. This way the inserts are not pulling OUT of the hole, but rather pulled INTO the hole from the back side.

I would make the fix myself, but I use Solidworks and can't seem to get the STEP file of the full assy to import. Can anyone send me just those two step files? I am concerned the horizontal screw that holds the two carriage parts together will interfere with this solution.

## Picture
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

pajtaz, 2023-09-15:
Let me add to this. I recently used Tap with Xol2 toolhead and on that toolhead I initially had to use M3 bolts from the front going into M3 inserts in the Tap carriage. However very quickly those M3 bolts were loose. Inserts themselves were ok but no matter how much I tightened (parts are also PCCF) the bolts came loose.

Recently I switched to the Xol toolhead. In the version I am using there are no inserts in the X carriage but there are M2.5 inserts in the hotend mount. M2.5 bolts go from the back of the X carriage into the hotend mount. I have now used that configuration for many hours in 77C to 80C chamber and even after decent speeds and accels, the bolts did not come loose and the heated inserts also did not come loose.

Therefore I would suggest to put the heated inserts into the back of the hotend mount and leave just a hole in X carriage/Tap carriage. Then use M3 bolts from the back of the X carriage/Tap carriage to secure the hotend. Maybe smaller bolts can still be used to secure Stealthburner main body to the hotend mount by putting another set of heated inserts in the front of the hotend mount.

wineds, 2023-11-13:
I have had a dreadful time with this issue.  Printer is Voron 2.4 REV C LDO kit with Voron Revo.  Original toolhead parts were PCCF but I have also tried ABS and PA11 Nylon CF.  I mostly print ABS at 250/110 C.  Since the V2.4 completion a few months ago I have been battling drifting Z offset.  Always in one direction.  Dissembled the toolhead and noticed heatset inserts were pulling out of the bottom (and to a lesser extent the CW2 mounts at the top).  Tried and ABS X carriage, same issue.  Tried a PA11 Nylon CF X carriage, same issue.  Tried Swapping the Omron inductive probe for Euclid but still drifting Z offset.  Eventually tried both printed and CNC TAP which resolved the issue.  Note that unlike some here I don't have X carriage distortion.
TAP is awesome but my preference was to run a Euclid probe.  I had some Square M3 nuts on hand so I decided to try to modify the X carriage STLs to suit.  I have been running a modified PA11 Nylon CF X carriage and the square nuts seem to have resolved the issue.  I did also print ABS versions but have not yet tested.
The square nuts are a tight fit in ABS, less so in PA11 Nylon CF.  When pressing them in be sure to start them straight then use a flat surface to force them flush with the X carriage surface.  You can then use a small flat head screwdriver to insert them to the correct depth.  If you overshoot you can use a small alley key to correct.
Square nuts :  https://au.element14.com/tr-fastenings/m3-sqst-z100bs4183/press-nut-square-bzp-m3-pk100/dp/1419469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  They also seem to be available from Newark/Farnell globally.

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

vajonam, 2023-11-16:
I had some similar issues. Voxelabsb ABS Pro. Usually print ABS only 265 to 270. I have just reprinted the parts. Considering going for aluminum X Carriage

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

sarkar-anwar, 2024-01-25:
Similar issue. This is the 2nd time. This time it was printed using 3dxtech ASA.

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

Zoro189, 2024-02-01:
I have same isue, PIF parts so there shouldn't be any issue with print quality. Lost heat insert and also hotend can be slightly rotated. I have dragon HF mounted on it. And I print mostly to this point only PLA on printer, so no high chamber temps. I maybe went trough 400g of ABS so far
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

Zoro189, 2024-02-26:
Some new pictures, same stealthburner from comment above
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

archi, 2024-07-24:
And another case here. This time with the Dragon UHF mount.
A design error in that mount accelerated this for me and caused the heatsets to survive only about 3h of ABS printing.
Additionally, I tightened the bolts really well (for "some reason" they always came loose, causing degraded IS results).

For the design error, I pinged the designer of the mount on Discord and we talked about it in in my build log.
See the message around here: https://discord.com/channels/460117602945990666/1260216015208448120/1265594856193921067

I first used Voron Tap, which survived it better (75h, give or take, also ABS printing). They have the inserts on the rear, but those were also pulled quite far into the plastic.

Some epoxy allowed me to fix my failing carriage and reprint the X carriage (the one with the UHF-compatible Cartographer mount from printables - https://www.printables.com/model/925457-beacon3dcartographer-probe-stealthburner-volcanouh). The inserts sit now much tighter, probably because didn't calibrate dimensional accuracy of ABS, yet (so all holes were to tight; a blessing in this case).

My ABS temps are 260C/105C/40-55C; I used the silicone sock, but had it the wrong way around; I doubt this had a large impact.

That concludes the anecdata from me. Images in the linked thread (but not from the failed X carriage - the holes were the inserts sat were gigantic though).

My very limited experience with these things indicates there is just too much heat with these hotend. Maybe moving the inserts to the back of the carriage and using 25mm longer screws solves this, maybe not. I'll try to reprint the parts in a more heat resistant material and eventually move to a CNC carriage. IMHO these are the most sane solutions, the ABS carriage will surely fail again (I'm sure to add the hints to my PRINT_START and PRINT_END, but they're just a stop gap). But there is always a next revision, and except for this setback I'm pleased with SB! So thanks for the huge effort you put into this, and keep up the good work :)

Saberjag, 2024-08-09:
I've been fighting this issue since March of 2023 and thought I was alone with this.  I've been replacing my x carriage every 3 months and sometimes gluing in my threaded inserts to get by to print replacement parts.  My klickly probe mount also needed to be replaced every 3 months.

To fix this, I just upgraded to CNC x carriage.
https://github.com/Vitalii3D-xyz/VoronLightweightXCarriage/

I had to redesign a mount for PCB klickly.

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

Thread 70 (2023-01-09):

Clockwork 2 Main Body bearing bore appears too large

cmgreyhounds, 2023-01-09:
When assembling my Stealthburner today I found that the bearing for the Bondtech gear was loose in the Main Body. I pulled the stl into Fusion 360 and checked and it looks to be around 8.20 mm, but the bearing is 8.00 mm. That is alot of play right next to the filament feed groove and could cause some amount of inaccuracy in extrusion.

nemgrea, 2023-01-18:
the cad dimensions and the actual print dimensions are not the same. this is intentional to account for ABS shrinkage and the FDM process

cmgreyhounds, 2023-01-18:
That makes sense, but why is the bore in the Main Body bigger than the bore in the Motor Plate?

If they both carry the same size bearing and are both made of ABS shouldn't they be the same size?

Closed 2023-01-18.

Thread 71 (2023-01-14):

[documentation] Mention access to 50t

boop5, 2023-01-14:
Page 30 is about setting backlash.

It could be helpful to mention that you can actually access the 50t to test the backlash. That would never have occured to me when I built my first voron (first printer).

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

On a side note: It'd be cool to get a link to a youtube video (or similar) like you do w/ the heat set insert QR code that maybe briefly explains what backlash is and how it should look like

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

neeamradia, 2023-01-15:
I agree completely, for people like me who have never worked with this kind of stuff before, this page was very confusing as it says 'slight play' but as I have never experienced this before, I didn't know how much play is required and 'slight' doesn't really help. Even 4-5 months after building the printer i have no idea!

nemgrea, 2023-05-05:
https://github.com/VoronDesign/Voron-Stealthburner/pull/88

Closed 2023-05-05.

Thread 72 (2023-01-16):

[STL] Volcano + Voron Stealthburner

pasha4ur, 2023-01-16:
Hello.

Please add volcano support. It is only a few millimeters longer than the standard V6 block.

I understand that the developers of the Voron are from rich countries and you are not very interested in people from less rich countries.

But the volcano is a cheap and productive solution. And V6 thermal barriers are a cheap consumable for printing with composites unlike dragons and other expensive solutions.

BerzerkaDurk, 2023-01-16:
Wow. That's a pretty insulting assumption.

pasha4ur, 2023-01-16:
> Especially given that they already included support for the standard V6 - the cheapest thing going.

I wrote about Volcano. They don't want to add it and wrote about this in their FAQ.

BerzerkaDurk, 2023-01-16:
They have hundreds of hours into developing the design for 7 different hotends all over the price spectrum. You can't reasonably expect them to accommodate every person's particular requests.
You could always take the freely supplied CAD files and modify them to suit yourself.

pasha4ur, 2023-01-16:
> They have hundreds of hours into developing the design for 7 different hotends all over the price spectrum. You can't reasonably expect them to accommodate every person's particular requests. You could always take the freely supplied CAD files and modify them to suit yourself.

II created a request not to you. Why are you breeding flood here? Do you have a boring life and have nothing else to do?

This man supports even more hotends and modules https://main.eva-3d.page/getting_started/

BerzerkaDurk, 2023-01-16:
welp, i have no idea what "breeding flood" is supposed to mean, but if you are going to come on here and take a dump on the people who have spent untold amounts of their free time designing these things and freely giving away their time and energy to helping people around the world and accuse them of not caring about people from less fortunate countries merely for not wanting to spend hours and hours accommodating one person's request, then yeah, i'm gonna say something.

BerzerkaDurk, 2023-01-16:
...and if you think that guy designs better printers and supports what you want to use, by all means go with his design. lol

pasha4ur, 2023-01-16:
> ...and if you think that guy designs better printers and supports what you want to use, by all means go with his design. lol

It seems to me that you are nobody to give instructions to anyone.

I don't want to waste time talking to useless you.

Lordinio, 2023-01-16:
[here](https://letmegooglethat.com/?q=stealthburner+volcano&l=1)

Haxk20, 2023-01-16:
OK i will just ignore the incredibly toxic comments above and give you answer as if you didnt say them.

There are few reasons why Volcano and other super high flow hotends as super volcano and rapido ultra high flow is that they are far too long. In case of volcano and super volcano they are so long that the heatbreak has tendency to bend when the nozzle hits something.

The final nail in the coffin tho is that stealthburner has airflow optimized cooling path. If the team were to extend this the entire work put into optimizing this would have to be reworked. Which is in the good range of few hundred hours.
Nobody wants to do this. And if you simply just extend it you are loosing bunch of the efficiency.

+ volcano can be easily replaced by going Dragon HF with CHT nozzle. I understand the price point. 100euro is a LOT to pay for a hotend. But so is VORON itself. The printer itself is expensive. But you do get what you pay for it. An amazing hotend that will get at least 30mm/s^3 and with CHT even 40. So the price is very much justified. And the reasoning behind not doing volcano and etc support is solid. The CAD is there. You can always grab the cad and modify it yourself and spend the hundreds of hours badnoob spent himself on optimizing the flow.

pasha4ur, 2023-01-16:
Not a super volcano is not long enough to have an impact.  It also has a narrower heatblock than the regular v6. This contributes to better blowing of the part.  I have one of those printers that comes with a volcano from the factory.

nemgrea, 2023-01-16:
this isnt an issue its a feature request, thats not what github issue tracking is for. closing.

KiloQubit, 2023-01-16:
@pasha4ur your replies in this thread are not in the spirit of being excellent to each other.  Be polite, do better.

As for your request, it has been answered, and we have no current plans to support the Volcano.  "not long enough to have an impact" is incorrect, the airflow is optimized to blow right at the tip of the nozzle, anything longer will need the ducts to be modified to move where the airflow hits.

pasha4ur, 2023-01-16:
"Plus volcano can be easily replaced by going Dragon HF with CHT nozzle. I understand the price point. 100euro is a LOT to pay for a hotend."

And we will change these 2 components each time after 1-3 spools of hard composite materials?

pasha4ur, 2023-01-16:
> @pasha4ur your replies in this thread are not in the spirit of being excellent to each other. Be polite, do better.
>
> As for your request, it has been answered, and we have no current plans to support the Volcano. "not long enough to have an impact" is incorrect, the airflow is optimized to blow right at the tip of the nozzle, anything longer will need the ducts to be modified to move where the airflow hits.

Do you have any evidence of the short volcano problem?  For example, physical simulations.  You may have found problems that the huge staff of engineers with specialized education who work in e3d and other companies did not guess about.

KiloQubit, 2023-01-16:
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

Extensive airflow simulations have been done to arrive at the current design, with airflow pointed exactly where the design has the nozzle.  Moving the nozzle lower will certainly impact it.

As mentioned, we have no plans to support the volcano as this time.  As this is an open source project, feel free to modify the CAD yourself to add such support.

pasha4ur, 2023-01-16:
You are moving away from the answer to another topic.  I was asking about simulating the short volcano hotend problem, not the air flow.  Anyone understands that the thinner part of the short volcano will give more maneuvers with the location of the blowing nozzles.

Closed 2023-01-16.

Thread 77 (2023-02-11):

TOOL CARTRIDGE Screws (Page 41)

SharkyMoto, 2023-02-11:
The manual calls for M3x12mm screws here, but when using the Rapido cartridge, those are too short (0-1 Threads engagement), 16mm works great though, so maybe worth mentioning it in the Manual.
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

stahlfabrik, 2023-02-16:
Same is true for the revo voron! I came here to see if there is an issue for this. The 12mm would not engage with the thread for me.

stahlfabrik, 2023-02-16:
Ah no - one headset I pushed to far in... the other is ok with 12mm

massis87, 2023-04-27:
I agree, I had the exact same issue. My inserts were pushed to just proud of the service and then leveled by cooling them down pressing onto a polished granite surface, so they're completely flush, yet they would not engage. 16mm worked perfectly.

nemgrea, 2023-05-05:
https://github.com/VoronDesign/Voron-Stealthburner/pull/88

Closed 2023-05-05.

Thread 78 (2023-02-12):

ERCF Compatibility with ClockWork 2

ccfman2004, 2023-02-12:
Does CW2 have a cutout needed to mount the internal filament sensor needed for the ERCF?

ddrachau, 2023-02-20:
https://github.com/EtteGit/EnragedRabbitProject/tree/main/usermods/CW2_with_ECAS_and_optional_sensor

Closed 2023-02-20.

Thread 79 (2023-02-16):

Dragon STL Issue

kogdog, 2023-02-16:
stealthburner_printhead_dragon_front.stl has the fan in the model?
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

BerzerkaDurk, 2023-02-16:
lol. that acts like the stator in a jet engine: it "straightens" the air passing through to reduce turbulence in the airstream and create a more laminar airflow.

If it wasn't supposed to be there, I'm sure the 3000 people who have printed these might've noticed.

Cheers.

kogdog, 2023-02-16:
thx

Closed 2023-02-16.

Thread 80 (2023-02-21):

ADXL Mount, mounting screws to Toolhead (Page 69)

SharkyMoto, 2023-02-21:
While the M2x10 Screws to mount the PCB to the bracket are specified, the screws needed to mount it to the actual toolhead are not.

nemgrea, 2023-05-05:
https://github.com/VoronDesign/Voron-Stealthburner/pull/88

Closed 2023-05-05.

Thread 82 (2023-03-16):

Part cooling fan - unbalanced airflow

btthrt, 2023-03-16:
Hi guys

Decided to move from AB-BN to Stealthburner.

The first thing I've noticed is that part cooling airflow is now not even close to uniform.
With AB-BN it was around 60-40, with stealthburner it's more 90-10 which results in uneven cooling and yada yada yada.

Tried with 2 fans: original sunnon and gdstime. No luck.

btthrt, 2023-03-16:
Fan setting: spin-spin to push the air in
Toolhead: any
Photos: posts pictures of air

Also, both gdstime and sunnon rotors are not centered on the inlet. This known issue can potentially contribute.

How to reproduce the main issue:
- keep toolhead attached or not, does not matter
- put a glass of water close to the print head nozzle, right between the fan ducts
- turn part cooling fan on
- observe water being pushed from left to right, since there is no air pressure in the right fan duct

raymondh2, 2023-03-17:
What toolhead are you using?

btthrt, 2023-03-17:
Does it really matter? They all have the same internal structure.
I've tried dragon, revo and rapido toolheads, all perform the same.
My guess - this whole problem is due to stealthburner's intake design, especially how the  part cooling fan is seated. (!!!) Not the toolhead design.

If you place your hand near the inlet, you can feel that the fan is actually pushing a substantional ammount of air back.
My guess is, again, this is due to the rotor being off-centered and due to enormous gap between the rotor and the intake.
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

Closed 2023-04-03.

Thread 85 (2023-04-23):

Part "pcb_spacer" and the two related screws not in manual

miracuruzrh, 2023-04-23:
Hi

I have not seen any mention of the red "pcb_spacer" and the two screws in the manual.
Maybe they should be added in the manual. I'm not 100% sure if it's correct. It seems to me that M3x6 screws should be used.
Then it would be 1.8mm clearance to the bottom of the hole, where the insert is screwed in. Is this correct?
A M3x8 screw would not be able to be tightened completely, as the screw would touch the bottom of the hole and the "pcb_spacer" would have 0.2mm clearance. Or in other words, the screw is 0.2mm to long if a M3x8 would be used. Hopefully that's correct.
I have attached a drawing as well.
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
[Clockwork2.pdf](https://github.com/VoronDesign/Voron-Stealthburner/files/11302897/Clockwork2.pdf)

BerzerkaDurk, 2023-05-05:
Side note: it doesn't look like you accounted for the 1.6mm board thickness in your model.

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

nemgrea, 2023-05-05:
ah ok, ill re-open this but list it as a CAD issue then instead i think that fits better than a manual tag

BerzerkaDurk, 2023-05-05:
> ah ok, ill re-open this but list it as a CAD issue then instead i think that fits better than a manual tag

Sorry, nemgrea. I didn't mean you. I was directing that at OP who said that the M8 was too long, but it doesn't look like they included the board thickness in their calculation.

Thread 89 (2023-05-06):

Phaetus Rapido Printhead Readme/BOM lists Wrong Screw Size

SuperDodge, 2023-05-06:
The Phaetus Rapido Printhead Readhme/BOM lists 2 M3x12 SHCS to be used to hold the two 3D printed parts together; however, those screws are not long enough to work.  M3x16 SHCS should be used.

BerzerkaDurk, 2023-05-06:
https://github.com/VoronDesign/Voron-Stealthburner/issues/37

nemgrea, 2023-05-08:
duplicate, and fixed

Closed 2023-05-08.

Thread 92 (2023-05-19):

Main Body sliced wrong

Steven2k6, 2023-05-19:
When I slice the MainBody, the external Permiters are buggy.

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

nemgrea, 2023-06-04:
this is a slicer issue on the user end not an issue with the STL

Closed 2023-06-04.

Thread 93 (2023-06-09):

Is the CW2 extruder configuration not provided?

garyd9, 2023-06-09:
The firmware directory should include a sample [extruder] configuration snippet for a suggested configuration to start with for CW2.  For example, gear_ratio and rotation_distance.  It might also be useful to include this information in the PDF manual.

nemgrea, 2023-07-07:
theres a pull request in the trident, V2.4 and switchwire repos right now that changes the default gear ratio to 50:10 for CW2

Closed 2023-07-07.

Thread 99 (2023-07-11):

X Carriage Hardware

1John419, 2023-07-11:
In the Voron Stealthburner Manual (2022-06-30), on page 61, a M3x40 SHCS is indicated on top and a M3x30 SHCS on bottom of the X Carriage halves. This is also reflected in the Voron step file.

I may be completely wrong (this is my first build), but I printed these parts and find that a M3x30 SHCS is appropriate for both top and bottom. This is also reflected in the STL files (x_frame_V2TR_MGN12_left.stl and x_frame_V2TR_MGN12_right.stl). The depth of the hex nut recess is 9mm top and bottom. The socket head recess is 6.6mm top and bottom. This would also suggest the same screw top and bottom.

The same discrepancy appears on page 140 of the Voron 2.4R2 Build Guide (2022-07-04).

nemgrea, 2023-07-11:
fixed

1John419, 2023-07-11:
So, the X Carriage STL folder has been removed completely. Does this mean that the V2.4 STLs should be used instead and that I need to reprint these parts (the right side is noticeably different)?

nemgrea, 2023-07-11:
the x carriages are on their way to the respective printer repos, you can pull them from the pending PR's or you can roll the SB repo back and get them from there. we're in the middle of replacing afterburner with stelathburner across all the repos

Closed 2023-07-11.

Thread 100 (2023-07-12):

Update 14h ago accidentally removed shroud

Marshalldog, 2023-07-12:
hey
"[[a]_stealthburner_main_body.stl](https://github.com/VoronDesign/Voron-Stealthburner/blob/main/STLs/Stealthburner/%5Ba%5D_stealthburner_main_body.stl)" is incorrect, there's now no cooling shroud

Anollya, 2023-07-12:
... and the STLs\Clockwork2\Direct_Drive\main_body.stl is the old one?  [a]_stealthburner_main_body.stl is the new main_body.stl?
What are the difference in the new release? Chancelog?

Marshalldog, 2023-07-12:
the shroud was replaced with a clockwork 2 part

nemgrea, 2023-07-12:
https://github.com/VoronDesign/Voron-Stealthburner/pull/101
fixed

Closed 2023-07-12.

Thread 103 (2023-07-12):

Filename change on manual pdf breaks link on vorondesign.com

akonkol, 2023-07-12:
hey folks! broken manual link on https://vorondesign.com/voron_stealthburner for the manual:
it links to: https://github.com/VoronDesign/Voron-Stealthburner/raw/main/Manual/Assembly_Manual_SB.pdf
and I think it should link to https://github.com/VoronDesign/Voron-Stealthburner/blob/main/Manual/Assembly_Manual_SB_High_Contrast_7-7-23.pdf
Which was caused by a filename change introduced in https://github.com/VoronDesign/Voron-Stealthburner/commit/a3366cfdb4ab51f14771ab681128a3d72f70b06f

nemgrea, 2023-07-13:
this should fix it https://github.com/VoronDesign/Voron-Stealthburner/pull/104

Closed 2023-07-13.

Thread 105 (2023-07-16):

Heat break curling issue

Fuechsl, 2023-07-16:
You wrote it in the very last sentence in readme.md. I had this issue, it caused clogs and took me endless time to figure it our. Thus, I propose to write more about this potential problem in bold letters as in:

**Be very careful not to overtight the three titanium alloy screws.** If not, you may curl the upper part of the heat break which leads to filament jamming and clogging. It is better to use the grub screw and the little "plug core" (called like this by phaetus) to fix the heater part in position and tighten the three titanium alloy screws just snug.

Thread 106 (2023-07-20):

Gap in newly filled area in CW2 motor plate

jagerman, 2023-07-20:
When slicing the new CW2 motor plate, I noticed an expected bit of bridging in the sliced model:

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

The bridging is at height 6.2 (occurs in current versions of PrusaSlicer and OrcaSlicer; I didn't try other slicers):

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

and if I look at height 6.0 I see exactly one layer of the older motor plate shape:

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

It seems that the old shape is not *quite* completely filled in by the new one and so the slicer is still drawing the old shape for one layer before switching to the new filled-in shape.

Thread 107 (2023-07-22):

Part cooling is not symmetrical (X-axis)

maxim-kukushkin, 2023-07-22:
I've recently assembled my Voron Trident with Stealthburner (LDO kit) and I'm seeing issues printing PLA due to extensive amount of warping. The warping is not symmetrical and suggests issues with part cooling in Stealhburner's duct.

The hotend that I'm using is **TriangleLab Dragon HF**. However, given the placement of the cooling it doesn't matter.

The cooling duct vents are located in front (along Y-axis). And they blow at the nozzle at an angle. I.e., the air flow is symmetrical along Y-axis, however, it's not symmetrical along X-axis.

It can be clearly seen on the printed parts, where majority of warping happens at the back (opposite side from cooling vents). See the pictures below.

There's no air leakage. Also, the same PLA has previously been used on a super cheap Prusa i3 clone, inside and enclosure, but with symmetric cooling ducts pointing strait to the nozzle from left and right along X-axis and it was printing perfectly, both high speed and low speed.

So, what I'm trying to say here is that the problem is the shape and location of the air vents for part cooling, not the filament, enclosure, speed, etc.

Would you consider slightly changing the design of the hotend cartridge to direct the flow symmetrically along both X and Y axes? I think similarly to how it's done in Afterburner (meanwhile I'll try to downgrade my printer to Afterburner to see how that one performs). But to me it's obvious - if the air flow is not symmetrical, the effect of it will not be symmetrical too and I've already had a chance to confirm that in the past when trying different cooling ducts.

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

maxim-kukushkin, 2023-07-30:
For comparison, this is how the exact same file was printed using Afterburner (same printer, same hotend, same gcode, same closed doors, just different toolhead).

It still has some issues (especially in front), but it's not even comparable with Stealthburner's result.

This is because Afterburner uses fully symmetric part cooling and the air vents are directed right at the nozzle tip.

The reason Afterburner's result is not ideal is:
- too long air vents (they should be around 3 times shorter)
- less performant fan (4020)
Otherwise the 3DBenchy would have perfect overhangs.

This can be achieved with Stealhburner if it's slightly redesigned to direct the air flow differently (like explained above). It doesn't have fan power issues, it only needs cooling ducts to follow AB's design, but have slightly shorter vents.

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

Biffes, 2023-08-02:
Hi there,
i have some trouble with pla on the left side of benchy too. I did some testing an the airflow seems to be slightly off to the front of sb. Here are some pictures:

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

mdvorak, 2023-08-04:
I did not do any extensive tests, but I have same experience, cooling is not symmetrical. Overhangs are always worse from one side.
Using Dragonfly BMS.

nielssteigenga, 2023-08-05:
I'm experiencing the exact same issue. Made some video's with smoke added to visualise the airflow. I will post them asap.

maxim-kukushkin, 2023-08-26:
Just as a proof that it's possible to print PLA without warping in with the closed printer doors (without removing the acrylic panes, like many people suggest for printing PLA), below is my custom tool head based on Bondtech LGX Lite extruder.

The 3D benchy was printed on the same printer: same G-Code file, same hotend, same printer, same spool of filament, closed doors. My toolhead uses strong air flow directed **symmetrically** straight on the nozzle tip. See that there's no warping anymore.

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

maxim-kukushkin, 2023-08-26:
The above toolhead is work-in-progress and at the moment is in sort of POC stage. I'm planning to add a front cover and LEDs to it. After that I'm thinking to share it either on GitHub or Thingiverse, but no specific timelines yet

Biffes, 2023-10-22:
Hi, I just wanted to give you a small update.
I adjusted the ventilation ducts so that they extend behind the nozzle.
Unfortunately, this reduces the pressure significantly, so that too little air still reaches the part:

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

My current solution is that I have installed additional fans under the Y-axes. This solution works surprisingly well:

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

I used the "breeze" solution by jphalip ( https://www.printables.com/de/model/532824-breeze-auxiliary-fan-system-for-voron-24/files
 ) and modified it to 4020 fans with air ducts and used the multi_pin command to pair it with the parts cooler.

I still believe that the ventilation ducts of the SB can be optimized. Maybe it would help if you rotate the hot end fan 45 degrees and route the parts fan with a single air duct.

maxim-kukushkin, 2023-12-05:
It took me a while, but I finally managed to complete the design of the toolhead I drafted above and to write BOM and assembly instructions for it
It's now available both in form of OpenSCAD source code (GPLv3) and printable STLs. I've been using it for a couple of months now. Please, feel free to try it and I'd totally appreciate any feedback :)

Hopefully this idea can also be considered as proof-of-concept to support this Issue and hopefully improve the design of future Stealthburner's revisions (cause I'd really prefer to use a ready-made solution instead of spending a couple of months designing my own)

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

Thread 108 (2023-07-26):

Additional missing files

VoronManiac, 2023-07-26:
I went to print a replacement part but directory STLs/X_Carriage I see from earlier this year (3/11/2023) appears to be missing? or did it get moved?

lexyan, 2023-08-03:
X_carriage has been moved to Voron-2/Trident/Voron-0..... repositories

thetic, 2023-08-08:
switchwire is missing the carriage stls

nemgrea, 2023-08-08:
> switchwire is missing the carriage stls

no they arent.
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

thetic, 2023-08-08:
You're right. I didn't think to find them in the gantry directories.

Closed 2023-08-04.

Thread 109 (2023-08-06):

Y-Motor assembly, cad, screw length, skirts

grungywamp, 2023-08-06:
do not drink and git - posted on wrong project

Closed 2023-08-06.

Thread 110 (2023-08-28):

Divert airflow away from heatzone extension sock on Dragon HF.

MartijnGevaert, 2023-08-28:
The main difference between the standard flow and high flow dragon hotend is the addition of a ceramic sock that increases the length of the meltzone. To fit this in, without making the hotend longer, the heatbreak is moved up a bit.
You can clearly see this in the images below for both the Phaetus and TriangleLab standard and high flow versions:
Phaetus dragon              |  TriangleLab dragon
:-------------------------:|:-------------------------:
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 | 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

Unfortunately, there is only a single dragon hotend mount which always blows over the entire hole. This works fine for the standard flow version, but for the HF version this means a section of the airflow is flowing over the extended meltzone.

## Why does this matter?

There are multiple reports online of people complaining they have issues with PLA on the dragon HF, there are claims this is because they don't have enough cooling power on their heatbreak. Redirecting the airflow upwards towards the heatbreak would help with this.
It would also slightly improve volumetric flow and reduce power usage by the heater by no longer cooling the extended meltzone.

## Proposed solution

There is already a project for the Afterburner that tackles this:
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
On the right side of the image, you can see that a simple lip would direct the airflow away from the extended meltzone.

Although the lip might need to have a shape like the image below to make sure that the air being redirected upwards doesn't block of airflow to the bottom part of the heatbreak on the high flow version.
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
(source: https://www.printables.com/model/68970-dragon-hotend-high-flow-fan-duct-phaetus)

MartijnGevaert, 2023-08-31:
I had a quick go at what the design might look like. This is with the airflow redirection added:
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
And here's the original:
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

I won't share the step file because it's very rough/ugly. But this does show that it should be a relatively easy change, although I don't know the effects on airflow, except that it's probably safe to assume there will be less airflow over the meltzone.

Thread 111 (2023-08-29):

Missing folder x-carriage

DirkS2106, 2023-08-29:
Please insert the X_carriage folder again. Unfortunately it has disappeared and it is not possible to load the x-carriage for the Clockwork2 and Stealthburner.

Drachenkaetzchen, 2023-09-02:
Many people are asking about this all the time, please add some readme file which clarifies where to find the carriage files

Closed 2023-09-18.

Thread 116 (2023-09-29):

Rapido 2.0 thermistor wires block SB

gizzygizmo, 2023-09-29:
STLs in STLs/Stealthburner/Printheads/phaetus_rapido have been a bit of a squeeze on Rapido1.0 but were possible by clocking the output of the wires and bending them slightly.  On 2.0 it appears the thicker thermistor wires block the screw hole completely and you must egress the "front" as the "back" will block TAP.   If you egress the front you have to do some less than ideal u-turns and bending/shoving to get things in place.

gizzygizmo, 2023-09-29:
Attaching pics for reference...

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

arkeet, 2023-10-05:
I hear a revision of the Rapido mount is in the works, but in the meantime this is how I ran the wires on mine:

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

gizzygizmo, 2023-10-05:
I'll give it a try... i didn't want to push to hard on the thermistor wires but i supposed it's not the end of the word if it breaks off, since it's easy to replace now at about $15.   I still have my original rapido if it it should break or cause issues before a new STL is released.

Can probably shave down the hole a little bit too... the through-screw is probably what's giving the structure/support here.

louis-evard, 2023-10-17:
I've made a minor modification to the parts to at least allow the thermistor to fit without forcing the base... Had to cut some landing surface from the screw tower and expose the main the screw, but built some landing surface back in other areas. I have not actually tested this yet
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

gizzygizmo, 2023-10-17:
Can you share the STL?  I'm rebuilding my hotend now and can test it with you... redoing w/ canbus+rapido2 and can test this out.  Looks like a viable interim solution to me.

louis-evard, 2023-10-18:
[stealthburner_printhead_rapido_2.0_fitment_mod_rev1.zip](https://github.com/VoronDesign/Voron-Stealthburner/files/12983464/stealthburner_printhead_rapido_2.0_fitment_mod_rev1.zip)

Here's the stl's, I included a modified f3d file also - my AutoCAD skills are not the best... still learning.

gizzygizmo, 2023-10-24:
Thanks for posting, i was able to print this out an test fitment and it looks good.  It's not ideal, but i think this is much better than trying to cram the wires out the front and wrap them around.  Moving material to the side will def help with support and thanks for doing both front & rear.   It had not occurred to me that the other side would likely need some adjustment too.

I'm still assembling CW2 + Canbus so will report back in a month or two once i've tested it in production.  For now, here's a shot of mine printed and centered:
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

kyleisah, 2023-10-24:
Fixed with PR #118

gizzygizmo, 2023-10-24:
> I'm not sure if I'm missing something here... I've printed the new PR 118 files, aligned the Rapido 2.0 grub screw thermistor and heater outputs but... I'm still unable to successfully mount the Rapido 2.0 in any orientation I appear to have to badly deform the thermistor output to an uncomfortable degree. Does anyone have any photos showing this correctly mounted?

Not sure either... i pulled the latest merge and see a new "2.0" dir with an STL that has a different MD5 than the original one... so they're technically different.  But importing them and overlaying on top of each other doesn't appear to show any diff in the mounting hole that blocks the temp sensor.

kyleisah, 2023-10-24:
@louis-evard https://media.discordapp.net/attachments/611278504914583562/1166478999011213322/IMG_0784.jpg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

this is the intended installation method. The heater wires and strain relief need to be bent down slightly to clear the screw boss, and the thermistor is routed above the screw boss.

The mounting holes were rotated a touch so the thermistor wires aren’t smushed up against the screw boss and have an adequate amount of room.

jagerman, 2023-11-18:
Is the intention here that the three screws attaching the heater to the heatsink have to be removed and the heatsink rotated to make this work?  I have two different brand new Rapdio 2's and neither match the photo without doing that adjustment.

gizzygizmo, 2023-11-18:
Yup... to use the PR/Merged rework you need to disconnect the top and rotate it so the set screw lines up matching the readme diagram here: https://github.com/VoronDesign/Voron-Stealthburner/blob/main/STLs/Stealthburner/Printheads/phaetus_rapido_v2/README.md

Full disclosure, i didn't like this solution and used the attached STL in this thread that chops the top of the screw hole and adds some material to the left.   Another user also proposed just sticking the wires out the front and doing a tight u-turn toward the back.   I'm sure all of the solutions work, i just chose the one that looked the most elegant to me.

mavera3, 2024-01-05:
> Yup... to use the PR/Merged rework you need to disconnect the top and rotate it so the set screw lines up matching the readme diagram here: https://github.com/VoronDesign/Voron-Stealthburner/blob/main/STLs/Stealthburner/Printheads/phaetus_rapido_v2/README.md
>
> Full disclosure, i didn't like this solution and used the attached STL in this thread that chops the top of the screw hole and adds some material to the left. Another user also proposed just sticking the wires out the front and doing a tight u-turn toward the back. I'm sure all of the solutions work, i just chose the one that looked the most elegant to me.

The documentation is not correct though. I just went through this with my rapido v2. The picture you show does work however the clocking of the screw holes compared to the grub screw and thermistor wires in your picture (that works) does not match what is shown in the documentation. The documentation says "Take care to ensure you are using the correct orientation for the V2, the following image just explains the process." The problem that I think needs correcting is to define what (via text or a second image) what that correct orientation is. Readers are left to determine this on their own and I and others in this thread were interpreting the documentation to say that the orientation shown is how the v2 should be clocked which is not correct.

mshrem, 2024-01-15:
So i am running into issues trying to mount my hotend, so i do not have any printer and ordered pif parts , the part is for the rapido , however i have the rapido v2 is there a difference ?

I am trying to do the steps provided in the guide for the rapido orientation however the only way that it works gives me a massive kiink on the spring wires.

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

Is this is how am i supposed to be doing this ?

mavera3, 2024-01-15:
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

I can't tell from your picture. Did you take off the hot side and rotate it so the grub screw is next to the thermistor and heater wires? Also the proper fitment doesn't have the wires flat against the printed part, they stick out some.  Like this picture.
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

mshrem, 2024-01-16:
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

Thanks , well it seems that my pif parts only included are for the rapido 1 not the 2 , i also have the HF version dont know if that affects the mounting or not.

So i asked my friend if he could print one for me since i do not have a printer capable of printing ABS.

Here are the results , dont know if this is what should look like.

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

Closed 2023-10-24.

Thread 117 (2023-10-12):

Tiny typo: psecific

atoomnetmarc, 2023-10-12:
Page 61:
Now: "please refer to the printer psecific manual for the correct bolt lengths"
Suggested: "Please refer to the printer specific manual for the correct bolt lengths."

atoomnetmarc, 2023-10-12:
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

Thread 122 (2023-11-13):

part cooling issue with E3D V6 and Dragon HF

bartoszwas, 2023-11-13:
Hey all,

I've installed a CHT 0.8 nozzle on my Dragon HF for some faster production on my printer but there's and issue with part cooling...
I have observed that air flow if concentrated about 10 mm BEHIND the nozzle (when looking from front).

I have changed to E3D V6 (got only this) and it's the same story. Airflow is nice but in wrong spot that makes my overhangs unprintable...
Before I had AB-BN (same 5015 fan) and everything was printing nice.

Thread 123 (2023-11-30):

Cooling related probloms with the Phaetus dragon SF and (Possibly) HF

Nathan22211, 2023-11-30:
Barring #110 from this, I have found 1 confirmed issue from another user and 1 possible issue I found myself.

First off, according to Nikita Jercov on Printables, there's quite a bit of backpressure with the dragon parts. He noticed the "fan intake had a fair bit of backpressure and puking air out of intake."
He remedied this somewhat with his backplate part on printables.

Then there's my issue, which I'm not sure if it's related to the lack of a silicone sock on my end or not. The issue being that Phaetus dragon hotend, the part cooling cools the heater block without the sock on. I don't know if this is a common occurance with other hotends like the Rapido or not though. Still, it is problematic if the user is commonly using CF ABS or CF nylon, as the temps required for those materials can degrade the sock.

Here's Nikita's part I was talking about. I can PR that and a potential fix to #110 that I found on printables as well when I get home if you want: https://www.printables.com/model/416006-enlarged-exhaust-ports-for-voron-stealthburner-pha

Thread 124 (2023-12-23):

Rapido 2 Toolhead: Orientation in README.md not correct.

Laikulo, 2023-12-23:
The supported orientation in the markdown file at STLs/Stealthburner/Printheads/phaetus_rapido_v2/README.md indicates that the grub screw should be at 4:30, and the wires at 12:00, with the screwhole nearest the wires at 12:30, however this orientation does not align the screwholes.

I found that the wires at 12:00, screw at 7:30 with the hole nearest the wires at 11:30 when viewed from the top (the face with the four holes as indicated.

Laikulo, 2023-12-23:
This is actually going to be user error. I misinterpreted the note about the orientation being different for the v2, and was unsure what figure to use. I just wound up testing all three orientations

michmerr, 2024-03-24:
I just went through this.

I think the "supported" alignment is correct, with the wires at 12 o'clock and the grub screw at 4 o'clock. _However_, the [alignment image with the element highlighted in blue](https://github.com/VoronDesign/Voron-Stealthburner/blob/main/STLs/Stealthburner/Printheads/phaetus_rapido_v2/Rapido_V2_Assembly_Images/v2_heatsink_orientation.png) shows the grub screw aligned with the wires, which is not correct.

Closed 2023-12-23.

Thread 125 (2023-12-29):

No Issue just a question.

Shakablestew, 2023-12-29:
Will the dragon printhead work with the UHF Dragon? I know it is a big difference in length with the extended melt zone piece that's why I am wondering.  Thank you in advance for any insight.

Closed 2023-12-29.

Thread 127 (2024-01-10):

Lubrication Clarification for SB Manual

dekay, 2024-01-10:
The page for the Guidler Arm Assembly states "Lubricate Bearings".  This is intended for the needle bearings only, but myself and others were uncertain if this applies to the MR85 bearings as well.  I suggest the wording be changed to "Lubricate Needle Bearings".  I'd also suggest adding a sentence on the Motor Plate page saying something like "The MR85 bearings are greased at the factory and do not require additional lubrication."

Thread 130 (2024-02-05):

Setup of Tension Knob and Anti Squish Thingymajig are not documented

dekay, 2024-02-05:
Page 29 of the SB manual discusses the purpose of the Anti Squish Thingymajig and Tension Knob but doesn't talk about how to adjust them.  The manual should go into this just as it does with the setting of the gear meshing.  Or at the very least, put in a link to [Dr Dave's excellent video that covers both subjects](https://www.youtube.com/watch?v=L1gxBCiE0pk).
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

Thread 131 (2024-02-24):

Missing main body CAD

Garethgb, 2024-02-24:
CAD files for all printheads and CW2 but cant find the main body CAD, only STL.

Bunny350, 2024-02-24:
Hi there,
It should be available in Stealthburner repository. If you need them, you can [click here](https://github.com/VoronDesign/Voron-Stealthburner/tree/main/CAD).

Garethgb, 2024-02-24:
> Hi there, It should be available in Stealthburner repository. If you need them, you can [click here](https://github.com/VoronDesign/Voron-Stealthburner/tree/main/CAD). _Proud owner and modder of two Voron printers._

Thanks. I was looking for it to be listed separately like the other parts but found it as the complete unit step file which is fine for what I need.

Closed 2024-02-27.

Thread 132 (2024-04-06):

Clockwork2: CAD / STL has insufficient tolerances - not printable.

dmradford, 2024-04-06:
The pieces [a]_guidler_a and [a]_guidler_b are supposed to interlock. However upon printing, they cannot be pressed together without damaging them. Inspecting the step file for Clockwork2, it becomes apparent why this is - they are designed with almost zero tolerance between the parts - 0.025mm to 0.05mm. This appears to be an oversight or misplaced decimal as other interlocking parts of the Clockwork2 use a 0.2mm tolerance, such as the interlocking pieces of the motor plate and the main body. I observed this same issue in other pieces of the Clockwork2 step file that are supposed to slide, not interlock, such as the interface between the shuttle and the main body, and the shuttle and the latch. These sliding parts should likely have a gap of 0.3-0.4mm to allow them to slide together smoothly (I got a smooth but snug fit with a tolerance of 0.25mm). Please advise if these should all be addressed here, or if I should create individual issues for each piece.

guidlers fit
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

motor plate and main body
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

stvptrsn, 2024-04-09:
The fit between the guidler halves is critical to keep the BMG idler parallel to the drive gear.  The current clearance is intentional and was the result of a long testing period where several revisions were evaluated among a large group of beta testers.  It is proven to be printable as evidenced by the number of Stealthburner/CW2 assemblies out there.  I've printed it countless times and although it has been tight when my print tolerances were off, even to the point of requiring me to check my settings (I was over extruding), it still goes together across a reasonably wide range.  All this said it is being discussed by the dev team to see if it makes sense to tweak it a little more.

dmradford, 2024-04-13:
Thank you for the insight. I now understand how tightly the parts are designed - even a slight interference fit. For injection molded parts in ABS, a +0.15mm interference is within range for an interference press fit. So printers capable of hitting 0.15mm tolerances, plus the 0.05mm gap, appears to add up. However that's per side. So to match a +0.15 interference fit using a printer tuned to within 0.15mm, the gap would need to be at least 0.15mm: 0.15mm * 2 sides, minus interference of 0.15mm gives you (0.15*2)-0.15=0.15mm gap between parts in CAD. To be fair, only the most highly tuned printers are capable of hitting tolerances of even 0.15mm, and yet with a 0.05mm gap between the parts, the printer would need to be capable of hitting ±0.05mm per part unless XY comp is used. This is 3x more precise than a very finely tuned FDM printer is likely capable of. Even CNC machines can struggle with these tolerances in metal. That's less than 0.002".

Knowing its meant to be an interference fit, I would still recommend increasing the gap to at least 0.1mm, and likely 0.15mm. I printed mine with a 0.2mm gap and it slid in without interference but was still snug enough to not have any play.

stvptrsn, 2024-04-13:
Thank you for your suggestion, we will update the parts if we determine it is required.

Closed 2024-04-13.

Thread 133 (2024-04-18):

optimize orientation for phateus rapido v2 plus

Avatarsia, 2024-04-18:
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

as visible in the picture, it would be much nicer to have a slight turn for cable managment woithout bending with too much force

Thread 134 (2024-04-22):

Which stl model is used for this hot end? I didn't find it.

tianyi725, 2024-04-22:
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

Which stl model is used for this hot end? I didn't find it.

Nicog77, 2024-04-24:
or here : https://www.printables.com/fr/model/323196-voron-stealthburner-for-bambu-lab-x1cx1-hotend

Thread 138 (2024-06-23):

Hotend Request - Spider V3

Fionoz, 2024-06-23:
A spider v3 mount for the mini-sb already exists, afaik. But nothing for the Stealthburner.

Here is the link of the step file (not mine) : https://grabcad.com/library/creality-spider-pro-hotend-1

And here is another reference link, for the STL (also not mine) :  https://www.printables.com/model/506366-creality-spider-30-hotend-referece-model

Also, just a side request, could you also make a model so that it gets secured with the creality hotend mounting system, instead of the 4x m2.5 screws?

Thread 139 (2024-07-14):

printhead STL for Phaetus Dragon needs manual modification after printing

SebKuzminsky, 2024-07-14:
I'm building my first Voron, using Tap, Stealthburner, and a Phaetus Dragon hot end.  The Stealthburner printhead part that's supposed to mate with the Tap doesn't have quite enough clearance to sit flat against the Tap.

The yellow circled areas are mated flush, but there's still a gap at the green circle:
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

It's not totally clear from the above picture, but the interference that prevents the part from mating flat against the Tap is the cutouts where the four screws that hold the Tap to the MGN-9 rail are.  In this picture you can see semicircular indentations in the printhead part from when i tried to press the printhead against the Tap, and it bumped into those screws and deformed the plastic a little bit:
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

This is the corresponding part of the STL:
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

I'm not the only person to run into this, e.g.:
https://discord.com/channels/460117602945990666/1041007230239125574/1171539492235116635

The manual does say to carve the plastic back to create clearance, and i did that, and it worked, but it seems a little incongruous with the excellent "fit and finish" of all the other Voron parts i've come across in my travels so far:
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

I'm opening this issue in the hope that someone will update the STLs to provide the required clearance, to make assembly easier for everyone.

DrPacemaker, 2024-12-08:
I ran into the same situation. This is really an issue:

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

I created a mod which solved it:

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

[https://github.com/DrPacemaker/Voron-Stealthburner-Phaetus-Dragon/blob/main/stealthburner_printhead_dragon_rear_cw2_mod.stl](url)

Thread 140 (2024-07-17):

Wrong files

Aleksbbgk, 2024-07-17:
When you download files from this link: https://github.com/VoronDesign/Voron-Stealthburner/releases/tag/1.0 , motor plate and main body of cw2 are not compatible.
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

i hope pictures will help.

nursereese, 2024-07-25:
Yep, I came here after printing the parts and finding the main body pieces incompatible.
The current release #98 includes the incorrect part.
I only found the "#101 sb shroud got lost" through a Google search for the correct file.

aceofjokers, 2024-08-12:
Considering its taken so long for someone to fix this....here are the files if anyone comes looking.
[CW2 body and plate.zip](https://github.com/user-attachments/files/16580032/CW2.body.and.plate.zip)

Thread 141 (2024-08-04):

Release STL for stealthburner main body is the wrong file

kurtjcu, 2024-08-04:
file in Voron-Stealthburner-1.0\STLs\Stealthburner\[a]_stealthburner_main_body.stl is one of the printheads bodies. I had to export stl from fusion to complete the set.

aceofjokers, 2024-08-12:
Incase anyone else comes looking for the files.....
[CW2 body and plate.zip](https://github.com/user-attachments/files/16580039/CW2.body.and.plate.zip)

foleac, 2024-09-27:
I don't think motoro_plate.stl was wrong. It is identical to the one in the repo, but [Clockwork2/main_body.stl](https://github.com/VoronDesign/Voron-Stealthburner/tree/main/STLs/Clockwork2/main_body.stl) is wrong. It does not fit the motor plate. The one in the repo works.

Thread 142 (2024-08-28):

Mounting screws are too short

cmezh, 2024-08-28:
The longer screws mounting Stealthburner to the carriage (M3x50) are too short. After being inserted all the way down, the tip of the screw doesn't even show up above the surface, it sits about 2-3 mm below.
M3x60 should be used instead.

cmezh, 2024-08-30:
My bad. My supplier put 2 M3x45 screws in the bag full of M3x50. And I, being very lucky man, pulled out exactly those short ones.

Closed 2024-08-30.

Thread 143 (2024-11-20):

Stealthburner for Rapido 1 CAD hotend mounting holes mistake

cromine11, 2024-11-20:
When looking at the Rear piece of the hotend mount there are slopes in the mounting holes. I did not notice these when modifying the file and have had mild, annoying issues for months now because I used it to make an STL that printed a bit better.
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
I check other toolheads and these are not seen on other models and not in the STL either

Thread 146 (2024-12-16):

Dragon CW1 Rear missing?

Dreded, 2024-12-16:
I have a voron v2.4 R1 and am wondering where I find the Dragon CW1 rear STL

https://github.com/VoronDesign/Voron-Stealthburner/tree/main/STLs/Stealthburner/Printheads/phaetus_dragon

Dreded, 2024-12-16:
found that there was a CW1 compatible branch(although I still think it should be with the rest of the STLs)
