VoronDesign/Voron-Stealthburner/(commit log)

2022-07-23 SB Release!!!!!!
    [MGN12_X_Carriage_CW2.stp, [a]_guidler_a.stl, [a]_guidler_b.stl, [a]_latch.stl, [a]_latch_shuttle.stl, [a]_pcb_spacer.stl, [a]_x_bearing_block_SW.stl, [c]_stealthburner_LED_diffuser.stl]
2022-07-25 Cutting jig and belt clips (#10)
    * Add files via upload
    * Add files via upload
    * Add files via upload
    * Delete 5015_DeEaring_Tool.stl
    * Delete 5015_DeEaring_Tool_B.stl
    * Add files via upload
    [SB_5015_Cutting_Tool_A.stl, SB_5015_Cutting_Tool_B.stl, [a]_Belt_Clamp_SW_x2.STL]
2022-07-25 BMS 7 fin fixes (#11)
    * Delete stealthburner_printhead_phaetus_bms7_front.stl
    * Delete stealthburner_printhead_phaetus_bms7_rear_cw1.stl
    * Delete stealthburner_printhead_phaetus_bms7_rear_cw2.stl
    * Delete Stealthburner_Printhead_Phaetus_BMS_7_Fin.stp
    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
    [stealthburner_printhead_phaetus_bms7_rear_cw1.stl, stealthburner_printhead_phaetus_bms7_rear_cw2.stl]
2022-07-30 add stealth CW1 pcb cover (#12)
    * Create Readme.md
    * Delete Readme.md
    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
    [Clockwork1_Pcb_Cover.stp, Pcb_Cover_Clip-On_Mount_cw1.stl, Pcb_Cover_cw1.stl]
2022-07-30 add stealthburner_leds.cfg (#15)
    * Create stealthburner_leds.cfg
    * Update stealthburner_leds.cfg
    [stealthburner_leds.cfg]
2022-07-30 Addressed a number of RC1 issues (#18)
    * Addressed a number of RC1 issues
    Clockwork2 STEP file colors have been fixed in Issue #16
    Part names have been corrected in SW Carriage #16
    Screw lengths have been corrected in #7 and #17
    Revised SB PCB Cover based on feedback from HartK.
    Corrected some missing esthetic features on the bottom of CW2 Main Body.
    * Ran Admesh on update STLs
    * Corrected issue with Main Body model and re-exported STL and STP
    * Update MGN12_X_Carriage_CW2.stp
    [MGN12_X_Carriage_CW2.stp, cable_door_for_pcb.stl, main_body.stl]
2022-08-16 Manual update (#27)
    page 42 - added note that other hotends might need different hardware
    page 67 - added callout for bolt length
2022-09-28 Whole lotta fixes (#32)
    * Whole lotta fixes
    All printheads have had a small modeling artifact removed from them
    All printhead CAD has been updated and re-exported
    V6 CAD has had weird broken mirror feature repaired
    All printheads have been harmonized to have same PTFE tube port diameter
    Switchwire carriage CAD has been bug-zapped
    Switchwire carriage CAD has had mount block added to it
    * Whole lotta fixes (Part 2)
    * Whole lotta fixes (Part 3)
    * Whole lotta fixes (Part 4)
    * Whole lotta fixes (Part 5)
    * Corrected bolt name in ADXL Assy
    Fixed a bolt name in the ADXL Subassembly in the Stealthburner Assembly CAD. Also changed filename of Stealthburner Assembly to includ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
    [Clockwork1_Pcb_Cover.stp, MGN12_X_Carriage_CW2.stp, SW_X_Carriage_CW2.stp, stealthburner_printhead_dragon_rear_cw1.stl, stealthburner_printhead_dragon_rear_cw2.stl, stealthburner_printhead_phaetus_bmo_rear_cw1.stl, stealthburner_printhead_phaetus_bmo_rear_cw2.stl, stealthburner_printhead_phaetus_bms6_rear_cw1.stl]
2023-01-17 Sanity's Stealthburner body update (#69)
    * Delete [a]_stealthburner_main_body.stl
    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
2023-01-17 change clamp part orientation (#52)
    * Delete [a]_Belt_Clamp_SW_x2.STL
    flip part orientation to match SW repo part
    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
    [[a]_Belt_Clamp_SW_x2.STL]
2023-01-24 Issue59 fix (#74)
    * Delete Stealthburner_Printhead_Rapido.stp
    * Delete stealthburner_printhead_rapido_rear_cw1.stl
    * Delete stealthburner_printhead_rapido_rear_cw2.stl
    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
    [stealthburner_printhead_rapido_rear_cw1.stl, stealthburner_printhead_rapido_rear_cw2.stl]
2023-01-24 Guidler_a fix (#73)
    * Delete [a]_guidler_a.stl
    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
    [[a]_guidler_a.stl]
2023-05-05 manual update (#88)
    * Delete Assembly_Manual_SB_highcontrast.pdf
    * Delete Assembly_Manual_SB.pdf
    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
2023-05-08 high contrast fix (#91)
    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
2023-07-10 Add "Mounting Hardware" column to toolhead readme. (#46)
    * Add "Mounting Hardware" column to toolhead readme.
    Adding hardware to aid users in toolhead assembly.
    * Update README.md
    Add more hardware notes
2023-07-11 Cw2 and ready to release (#98)
    * cw2
    * SB
    * bowden
    * cad
    * manual fix
    * manual fix
    * stl clean up
    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
    [Bowden_Module.f3d, Bowden_Module.step, Clockwork1_Pcb_Cover.stp, MGN12_X_Carriage_CW2.stp, Pcb_Cover_Clip-On_Mount_cw1.stl, Pcb_Cover_cw1.stl, SB_5015_Cutting_Tool_A.stl, SB_5015_Cutting_Tool_B.stl]
2023-07-12 Sb shroud got lost now its back (#101)
    * Delete main_body.stl
    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
    [main_body.stl]
2023-07-13 Manual link fix (#104)
    * Delete Assembly_Manual_SB_7-7-23.pdf
    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
2023-09-07 added missing 3 hole chain anchor for VT and V2 to the CAD assembly (#112)
    * added missing 3 hole chain anchor for VT and V2 to the CAD assembly
    * fixed chain anchor as it was not aligned properly it was off by almost 1mm in height and almost 2mm in Y direction
    added note to let users know the X carriage is in the printers repos
    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
    [chain_anchor_2hole.stl, chain_anchor_3hole.stl]
2023-09-07 switchwire xchain anchor fix (#113)
    [chain_anchor_2hole_SW.stl, chain_anchor_3hole_SW.stl]
2023-10-24 Add Rapido V2 Hotend Mount (#118)
    * add rapido v2 gubbins
    * Create readme.md
    * Update and rename readme.md to README.md
    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
    [stealthburner_printhead_rapido_v2_rear_cw1.stl, stealthburner_printhead_rapido_v2_rear_cw2.stl]
2023-10-25 call attention to potential pitfalls when rotating heatbrake (#97)
    * be more explicit with the rotation steps, calling as much attention as possible to the potential pitfalls...
    * port rapido reassembly warnings to v2
2023-10-25 Update broke Rapido V2 Files (#120)
    * uploade new images
    * Update Stealthburner_Printhead_Rapido_V2.step
    gave components appended names for V2 variant
    Updated readme with further instruction, and additional images
    * fix broken STL
    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
2024-01-22 Add missing CW1 BMO rear (#128)
    [stealthburner_printhead_phaetus_bmo_rear_cw1.stl]
2024-06-16 Update README.md (#137)
    Modify dragon hotend compatibility to show SB/SF/HF
2025-10-02 Chube Compact Update (#148)
    * Create stealthburner_printhead
    * Delete STLs/Stealthburner/Printheads/chube_compact/stealthburner_printhead
    * Rename sealthburner_printhead_chube_compact_rear_cw2.stl to stealthburner_printhead_chube_compact_rear_cw2.stl
    typo go brr
    * replacing for orientation things
    * Delete STLs/Stealthburner/Printheads/chube_compact/stealthburner_printhead_chube_compact_front.stl
    * Rename Stealthburner_printhead_chube_compact_front.stl to stealthburner_printhead_chube_compact_front.stl
    * Delete STLs/Stealthburner/Printheads/chube_compact/stealthburner_printhead_chube_compact_front.stl
    * Add files via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
    [stealthburner_printhead_chube_compact_rear_cw2.stl]
2026-11-08 Correct motor plate and shuttle STLs, manual (#154)
    * Remove duplicate shuttle
    * Update motor_plate.stl to previous main body recess; update [a]_latch_shuttle.stl to have 4.6mm heatset hole
2026-11-11 Update CAD to have part number match component names to assist Solidworks users.
